BIG-TTS/Hypnos/Hypnos/Programming/Accelerometer Configuration.odt

Accelerometer Configuration:

Control configuration:

- Standby mode with sample rate of 100Hz and low noise activated -> 0x1C into 0x2A register
- Select Low Noise Low Power as oversampling mode -> 0x01 into 0x2B register

Transient Control Configuration (Enable which axis is monitored):

- Write to Register 0x1D
- Write 0x0E -> This enables an Interrupt on all three axis
- Write 0x4E if event flags should be latched into SRC register

Transient Threshold Configuration (value to exceed for an event to happen):

- Write Register 0x1F
- Select 0.5g as Threshold -> 0.5g/0.063g -> 8 counts -> Write 0x08

Transient Counter Configuration (time for an event to persist, so it is recognized):

- Write Register 0x20
- Set timing of detection to 50ms -> 10ms Steps -> 50/10 -> Write 0x05

Transient Source Configuration (data on which axis and direction event occurred):

- Write Register 0x1E
- To clear event flag -> Read 0x40
- Bit 0-5 contain information about axis and direction (POLX, EVX, POLY, EVY, POLZ, EVZ)

System Interrupt Configuration:

- Enable the Interrupt for Transient detection -> Write Register 0x2D -> Write 0x20
- Route Transient Detection to Interrupt Pin 1 -> Write Register 0x2E -> Write 0x20
- To clear interrupt flag -> Write Register 0x0C -> Read 0x20

Put device into active mode:

- Write 0x1D into 0x2A register
