BIG-TTS/Hypnos/Hypnos/Programming/Clock Configuration.odt

STM32L431CC Clock Configuration

The clock configuration of Hypnos_V0 is described in individual sections for the main clocks. The system clock is driven by the PLL, which used the MSI as clock source. The MSI is configured to 4MHZ and auto calibrated by the LSE. The LSE provides the clock source for the RTC.

After leaving one of the low-power modes, the configuration of the MSI range is lost and set to the default value of 4MHz. So keeping this value for the whole configuration has the advantage that the MSI doesn’t need to be reconfigured after a reset.

The following steps have to be taken for the whole clock configuration of the system to work:

- Configure the RTC clock
- Configure the LSE
- Configure the MSI
- Enable power interface clock -> SET PWREN bit in RCC_APB1ENR1 register
- Set voltage regulator range -> Configure VOS bits in PWR_CR1 register
- Enable backup domain access -> SET DBP bit IN PWR_CR1 register
- Disable flash prefetch buffer -> Clear PRFTEN bit in FLASH_ACR register
- Enable flash instruction cache -> Set ICEN bit in FLASH_ACR register
- Enable flash data cache -> Set DCEN bit in FLASH_ACR register
- Configure Flash Latency -> Set Latency bits in FLASH_ACR register
- Configure the PLL
- Configure the System Clock

PLL (Phase-locked loop) clock:

The PLL is used to multiply the HSE, HSI or MSI output clock frequency and generate with these internal clock sources a much higher clock speed for the system.

- Disable the PLL -> Clear PLLON bit in RCC_CR register
- Wait until PLL is turned off -> Wait until PLLRDY bit is cleared in RCC_CR register
- Define the clock source for the PLL -> Configure PLLSRC bits in RCC_PLLCFGR register
- Set division factor for the input clock -> Configure PLLM bits in RCC_PLLCFGR register
- Set the multiplication factor -> Configure PLLN bits in RCC_PLLCFGR register
- Set division factor for output clock -> Configure PLLR bits in RCC_PLLCFGR register
- Enable PLL again -> Set PLLON bit in RCC_CR register
- Wait for PLL to be stable -> Wait until PLLRDY flag is set in RCC_CR register
- Enable PLL output -> Set PLLREN bit in RCC_PLLCFGR register

LSE (Low Speed External) Clock:

The LSE is an external crystal. It provides the clock source for the RTC and keeps the System clock accurate by trimming the MSI.

- Set crystal oscillator driving strength > Program LSEDRV bits in RCC_BDCR register
- Turn LSE crystal on -> SET LSEON bit in RCC_BDCR register
- Wait for LSE to be stable -> Wait until LSERDY flag is set in RCC_BDCR register
- Activate clock security system (only after clock source has been selected for the RTC) -> SET LSECSSON bit in RCC_BDCR register

MSI (Multi Speed Internal) clock:

The MSI is used as system clock after restart from reset, wakeup, standby and shutdown low- power modes. It is set to the default value of 4MHz.

- Change range with MSIRANGE[3:0] bits in RCC_CR register (keep at reset value)
- Turn on the MSI -> SET MSION in RCC_CR register
- Wait for MSI to be stable -> Wait until MSIRDY flag is set in RCC_CR register
- Enable auto calibration by LSE (PLL-mode) -> Set MSIPLLEN bit in RCC_CR register

SYSCLK (System clock):

The SYSCLK is the one, which drives the whole system. Different sources can be used. In this case, to allow auto calibration of the MSI, the PLL is used as source for the system clock.

- Configure AHB prescaler -> Configure HPRE bits in RCC_CFGR register
- Configure APB1 prescaler -> Configure PPRE1 bits in RCC_CFGR register
- Configure APB2 prescaler -> Configure PPRE2 bits in RCC_CFGR register
- Select the system clock source -> Configure SW bits in RCC_CFGR register
- Confirm status of clock source -> Wait until corresponding SWS bits are set in RCC_CFGR register

RTC Clock:

- Select LSE as clock source -> RTCSCEL = 01 in RCC_BDCR register
- Configure prescaler with 1Hz RTC clock -> PREDIV_A = 127 & PREDIV_S = 255
- Enable RTC clock -> Set RTCEN bit in RCC_BDCR register

Any changes in the backup domain register require a software reset by setting the BDRST bit in RCC_BDCR register

https://www.youtube.com/watch?v=GJ_LFAlOlSk
