BIG-TTS/Hypnos/Hypnos/Programming/I2C Configuration.odt

STM32L431CB I2C Configuration

I2C initialization:

- Make sure peripheral clock is configured and enabled -> Check configuration in RCC registers
- Disable the I2C clock -> Clear PE bit in I2C_CR1 register (also performs software reset)
- Configure Noise Filters -> ANFOFF, DNF in I2C_CR1 (Leave default configuration)
- Configure timings (Cube) -> PRESC, SCLDEL, SDADEL, SCLH, SCLL in I2C_TIMINGR register
- Enable the I2C clock -> Set PE bit in I2C_CR1 register

Data Transfer:

Reception:

- Data goes in shift register -> RXNE = 0
- Data goes in data register (I2C_RXDR) -> RXNE = 1
- Next Data goes in shift register -> Clock is stretched since shift and data registers are full
- After reading data in I2C_RXDR-> Clock is released, but RXNE stays set

Transmission:

- Data gets written into data register I2C_TXDR -> TXE is cleared
- Data goes to shift register -> Data register empty -> TXE = 1
- If no new data -> Clock is stretched since shift and data registers are empty
- After writing data in I2C_TXDR -> Clock is released, TXE stays set

Byte counter:

- The number of transferred and received bytes is counted
- In Master mode always enabled
- In slave mode can be enabled by setting SBC bit in I2C_CR2
- The number of bytes for transfer must be programmed -> NBYTES in I2C_CR2

Reload = 1

- If number of bytes to transfer is greater than 255 -> Set RELOAD bit in I2C_CR2
- If number of bytes have been written -> TCR flag is set and clock is stretched
- Interrupt is generated if TCIE set
- TCR is cleared by writing new non-zero value into NBYTES
- IF NBYTES reloaded with last number of bytes -> RELOAD bit must be cleared

Reload = 0 and AUTOEND = 1

- Stop condition automatically sent after NBYTES is reached in transfer

Reload = 0 and AUTOEND = 0

- Clock is stretched after NBYTES is reached in transfer
- TCR flag is set and clock is stretched
- Interrupt is generated if TCIE set
- TCR is cleared by sending RESTART or STOP condition

I2C master mode:

- Configure addressing mode (7-bit or 10-bit) -> ADD10 in I2C_CR2
- Write slave address to be sent -> Write into SADD in I2C_CR2
- Set Transfer direction -> RD_WRN in I2C_CR2
- Configure Byte counter -> NBYTES in I2C_CR2 (If greater than 255 -> Initially 0xFF)
- Send START bit in I2C_CR2

Master transmitter:

- TXIS flag set after each byte transmission
- TXIS event generated if TXIE bit set in I2C_CR1 register
- Transfer stops once the number of TXIS events corresponds to the number in NBYTES
- For Restart -> Set Start bit with proper slave address and NBYTES configuration
- For Stop -> Set Stop bit in I2C_CR2 register
- If NACK received -> TXIS cleared, STOP sent, NACKF set (Interrupt if NACKIE = 1 in I2C_ISR)

Master receiver:

- RXNE flag set after each byte reception
- RXNE event generated if RXIE bit set in I2C_CR1
- Reception stops once the number of RXNE events corresponds to the number in NBYTES
- For Restart -> Set Start bit with proper slave address and NBYTES configuration
- For Stop -> Set Stop bit in I2C_CR2 register

Before entering Stop mode, the I2C must be disabled if WUPEN = 0.
