BIG-TTS/Hypnos/Hypnos/Programming/Power Control Configuration.odt

Power control configuration

Voltage regulator:

Two embedded linear voltage regulators supply all the digital circuitries, expect for standby and backup circuitries. They’re always enabled after reset. Depending on the application modes, Vcore is either supply by the main regulator (MR) or the low-power regulator (LPR).

- In Run, Sleep and Stop 0 -> MR & LPR are on, Vcore is supplied by MR
- In LP run & sleep and Stop 1 & 2 -> Only LPR is on and supplies Vcore, SRAM 1 & 2 are preserved
- In Standby mode (RRS bit set) -> Only LPR is on and supplies SRAM2, everything is off except Standby and backup domain circuitry
- In Standby mode (RRS bit cleared) -> LPR & MR are off, only standby and backup domain circuitry are preserved
- In Shutdown mode -> LPR & MR are off, after exiting power-on reset is generated

Setting the RSS bit in PWR_CR3 register allows to retain the content of SRAM2 in standby mode

Voltage scaling management_

The main regulator output voltage (Vcore) can be programmed to two different power ranges (Range 1 and Range 2). After start-up, the voltage scaling is set to range 1.

- Range 1 is the high-performance range. The system clock can get up to the maximum. Flash access time is minimum.
- Range 2 is the low-power range. The system clock can only be up to 26MHz. Flash access time is increased.

To go from range 1 to range 2:

- Reduce the system frequency to 26Mhz or lower
- Adjust the Flash latency -> LATENCY bits in FLASH_ACR
- Select voltage scaling range 2 -> Set VOS bits to 10 in PWR_CR1 register

To go from range 2 back to range 1:

- Select voltage scaling range 1 -> Set VOS bits to 01 in PWR_CR1 register
- Wait until scaling has switched-> Wait until VOSF flag is cleared in PWR_SR2 register
- Adjust the Flash latency -> LATENCY bits in FLASH_ACR
- Increase the system frequency

Battery backup domain:

When VDD is not present, the backup domain is powered through the backup supply voltage VBAT. The switch is controlled by the power-down reset. The battery/capacitor connected to VBAT can be internally charged by the microcontroller:

- Enable battery charging -> SET VBE bit in PWR_CR4 register
- Chose battery charging resistor -> Configure VBRS bit in PWR_CR4

After a System reset, the backup registers are protected. To enable access to the backup domain:

- Enable power interface clock -> Set PWREN bit in RCC_APB+ENR+ register
- Enable access to the backup domain -> Set DBP bit in PWR_CR1 register
- Proceed with the RTC clock configuration

Run mode:

- In run mode, the clock and peripherals of the whole system are completely functional. The different clocks of the system can be configured individually to either reduce power consumption or switch into another mode.
- The HCLK and PCLK can be stopped at any time.
- Stop clock for individual peripherals with the RCC_AHBxENR and RCC_APBxENR registers.
- In sleep mode, disabling the peripherals clock can be performed automatically by resetting the corresponding bit in the RCC_AHBxSMENR and RCC_APBxSMENR registers

Low-power run mode (LP run)

- Maximum frequency cannot exceed 2MHz
- All I/o modes keep the same state as in run mode
- All clocks working, except PLL

To enter LP run mode:

- Decrease system clock to 2MHz or lower
- Force regulator into low-power mode –> Set LPR bit in PWR_CR1 register

To exit LP run mode:

- Force regulator into run mode -> Clear LPR bit in PWR_CR1 register
- Wait until System is ready -> Wait until REGLPF bit is cleared in PWR_SR2 register
- Increase system clock frequency

Sleep mode:

- All I/o modes keep the same state as in run mode
- Current Consumption drastically reduced
- All Clocks working
- CPU off

To enter sleep mode:

- Clear SLEEPDEEP bit in SCR register
- Make sure no Interrupt or Event is pending
- Enable Wakeup pin if used
- Set WFI or WFE instruction

Depending on configuration, sleep mode is exited in different ways:

- If WFI instruction set -> System wakes up if an interrupt occurs
- If WFE instruction set -> System wakes up if an event occurs
- If WFE instruction set (SEVONPEND bit in SCR register set) -> System wakes up if an interrupt occurs, even when not enabled in NVIC
- If SLEEPONEXIT in SCR register set -> System exits if an interrupt occurred and goes back to sleep mode after returning from the handler

Low-power sleep mode (LP sleep):

- All I/o modes keep the same state as in run mode
- Current Consumption drastically reduced
- All Clocks working, except PLL
- CPU off
- Can only be accessed from LP Run mode

To enter LP sleep mode:

- Clear SLEEPDEEP bit in SCR register
- Make sure no Interrupt or Event is pending
- Enable Wakeup pin if used
- Set WFI or WFE instruction

Depending on configuration, LP sleep mode is exited in different ways:

- If WFI instruction set -> System wakes up if an interrupt occurs
- If WFE instruction set -> System wakes up if an event occurs
- If WFE instruction set (SEVONPEND bit in SCR register set) -> System wakes up if an interrupt occurs, even when not enabled in NVIC
- If SLEEPONEXIT in SCR register set -> System exits if an interrupt occurred and goes back to sleep mode after returning from the handler

Stop 0 mode:

- All I/o modes keep the same state as in run mode
- Current Consumption is reduced t 108uA
- Only LSE and LSI clock working
- Several peripherals are still functioning
- CPU off

To enter Stop 0 mode:

- Set the SLEEPDEEP bit in SCR register
- Select STOP 0 as LP mode -> SET LPMS to 000 in PWR_CR1 register
- Make sure no Interrupt or Event is pending
- Enable Wakeup pin if used
- Set WFI or WFE instruction

Depending on configuration, stop 0 mode is exited in different ways:

- If WFI instruction set -> System wakes up if an interrupt (external or peripheral with wakeup capability) occurs
- If WFE instruction set -> System wakes up after if an external event occurs
- If WFE instruction set (SEVONPEND bit in SCR register set) -> System wakes up if an interrupt (external or peripheral with wakeup capability) occurred, even when not enabled in NVIC
- If SLEEPONEXIT in SCR register set -> System exits if an interrupt occurred and goes back to sleep mode after returning from the handler

After exiting Stop 0 mode, either the MSI or the HSI16 is selected as System clock. It depends on the STOPWUCH bit in the RCC_CFGR register. Set for HSO16, cleared for MSI. The MSI allows faster wakeup time and higher clock frequency after reset. He MCU is after exiting either in run mode range 1 or 2.

Stop 1 mode:

- All I/o modes keep the same state as in run mode
- LPR is used which allows less current consumption (4.63uA with RTC)
- Only LSE and LSI clock working
- Several peripherals are still functioning
- CPU off
- Can be entered from Run or LP Run mode

Entering and exiting is the same as stop 0 mode with the only difference of LPMS set to 001

Stop 2 mode:

- All I/o modes keep the same state as in run mode
- LPR is used which allows less current consumption (1.4uA with RTC)
- Only LSE and LSI clock working
- Only few peripherals still functioning
- CPU off
- Can only be entered from Run mode

Entering and exiting is the same as stop 0 mode with the only difference of LPMS set to 010

Standby mode:

- SRAM1 contents are lost
- SRAM2 content preserved depending on the RSS bit in PWR_CR3 register
- CPU off
- Only BOR, RTC and IWDG functioning
- I/O configuration can be floating, pull-up or pull-down
- Only LSE clock on

To enter standby mode:

- Set the SLEEPDEEP bit in SCR register
- Select standby as LP mode -> SET LPMS to 011 in PWR_CR1 register
- Clear WUFx bits in PWR_SR1 register
- Make sure no Interrupt or Event is pending
- Enable Wakeup pin if used
- Set WFI or WFE instruction
- If SLEEPONEXIT in SCR register set -> System goes back to sleep mode after returning from the ISR handler (only if RTC flags cleared)

Depending on configuration, standby mode is exited in different ways:

- Rising edge on Wakeup pin
- RTC event
- External reset
- IWDG reset

After exiting standby mode, the SBF status flag in PWR_CR3 is set to indicate it was in standby mode. All registers are reset after a wakeup, except PWR_CR3. GPIOS keep their configuration from standby mode until the APC bit in PWR_CR3 has been cleared. The pin configuration of the I/O in standby mode is lost after waking up

Shutdown mode:

- SRAM1 and SRAM2 contents are lost
- CPU off
- Only RTC functioning
- I/O configuration can be floating, pull-up or pull-down
- Only LSE clock on
- 200nA power consumption with RTC

To enter shutdown mode:

- Set the SLEEPDEEP bit in SCR register
- Select shutdown as LP mode -> SET LPMS to 1xx in PWR_CR1 register
- Clear WUFx bits in PWR_SR1 register
- Make sure no Interrupt or Event is pending
- Enable Wakeup pin if used
- Set WFI or WFE instruction
- If SLEEPONEXIT in SCR register set -> System goes back to sleep mode after returning from the ISR handler (only through external RTC event possible and if flags cleared afterwards)

Depending on configuration, shutdown mode is exited in different ways:

- Rising edge on Wakeup pin
- RTC event
- External reset

The whole system is completely reset. All registers are reset, except for the backup domain

Auto-wakeup from low-power mode through RTC

- To wake up from stop mode through a RTC alarm -> configure EXTI line 18 to be sensitive to rising edge
- To wake up from a stop mode through a RTC wakeup event -> configure EXTI line 20 to be sensitive to rising edge
- To wake up from standby there is no special configuration necessary

https://www.youtube.com/watch?v=O82rj9qxkgs

Important: 3.3.3 Read access latency
