BIG-TTS/Hypnos/Hypnos/Programming/RTC Configuration.odt

Configuration of the RTC

Calendar Configuration:

- Disable write protection -> Write 0xCA and then 0x53 in RTC_WPR register
- Enter Init mode -> Set Init Bit in RTC_ISR register
- Wait for confirmation of Init mode -> wait until INITF bit is set in RTC_ISR register
- Program prescaler value in RTC_PRER register -> per default 1Hz
- Write time and date in register -> RTC_DR (Date) & RTC_TR (Time)
- Configure time format -> Clear FMT bit in RTC_CR (24hour format)
- Exit Init mode -> Clear Init bit in RTC_ISR register
- Enable write protection -> Write 0xFF into RTC_WPR register

Clock Configuration:

- Select LSE as clock source -> RTCSCEL = 01 in RCC_BDCR register
- Configure prescaler with 1Hz RTC clock -> PREDIV_A = 127 & PREDIV_S = 255
- Enable RTC clock -> Set RTCEN bit in RCC_BDCR register

Any changes in the backup domain register require a software reset by setting the BDRST bit in RCC_BDCR register

Alarm Configuration:

- Disable write protection -> Write 0xCA and then 0x53 in RTC_WPR register
- Disable Alarm A(B) -> Clear ALRA(B)E bit in RTC_CR register
- Wait until alarm register can be accessed -> wait until ALRA(B)WF is set in RTC_ISR register
- Configure alarm -> Write into RTC_ALRMA(B)R register (must be same format as calendar)

WDSEL defines whether the date or only the weekday is represented in the alarm.

- Re-enable alarm -> SET ALRA(B)E bit in RTC_CR register
- The alarm interrupt is enabled through the ALRA(B)IE bit in the RTC_CR register

Alarm behaviour configuration:

The alarm behaviour is configured by the MSKx bits in the RTC_ALRMA(B)R register. They can be set independently from each other.

- IF MSK0 = 1 -> Seconds don’t matter in comparison
- IF MSK1 = 1 -> Minutes don’t matter in comparison
- IF MSK2 = 1 -> Hours don’t matter in comparison
- IF MSK3 = 1 -> Weekday or date don’t matter in comparison

Alarm sub-second configuration:

The RTC unit provides programmable alarms, sub-second A and B, which are similar. They generate alarms with a high resolution (for the second division).

The value programmed in the alarm sub-second register RTC_ALRMASSR is compared to the content of the sub-second field in the calendar unit.

The sub-second field counter counts down from the value configured in the synchronous prescaler (PREDIV_S) to zero, and then reloads a value from the RTC_SPRE register.

- Write the sub seconds value to be compared -> Set SS bits in RTC_ALRMASSR register
- Mask the most significant bit to be compared -> Set MASKSS bits in RTC_ALRMASSR regiser

Periodic wakeup unit:

This unit is able to wake up the system from low-power modes. It uses a programmable down-counting auto-reload timer. Once the counter reaches zero, a flag and interrupt is generated. An alternate function output is also available which can be routed to RTC_ALARM output.

- Disable write protection -> Write 0xCA and then 0x53 in RTC_WPR register
- Disable wakeup timer -> Clear WUTE bit in RTC_CR register
- Wait until wakeup registers can be accessed -> Wait until WUTWF bit set in RTC_ISR register
- Program wakeup timer value _> SET WUT bits in RTC_WUTR register
- Select LSE as clock source for short wakeup periods -> WUCKSEL bits = 0b0xx in RTC_CR register
- Configure prescaler to select resolution

If Wucksel = 000 -> Division = 16

If Wucksel = 001 -> Division = 8

If Wucksel = 010 -> Division = 4

If Wucksel = 011 -> Division = 2

- Re-enable wakeup timer -> SET WUTE bit in RTC_CR register
- Enable write protection -> Write 0xFF in RTC_WPR register
- The periodic wakeup interrupt is enabled through the WUTIE bit in the RTC_CR register

Backup System:

- Data can be saved in this register. They keep being powered on, even if VDD is switched off.
- 32 Bits are available
- It is not reset by a system reset

After a System reset, the backup registers are protected. To enable access to the backup domain:

- Enable power interface clock -> Set PWREN bit in RCC_APB+ENR+ register
- Enable access to the backup domain -> Set DBP bit in PWR_CR1 register
- Proceed with the RTC clock configuration

Reading the calendar:

APB1 clock (fplclk) must be at least 7 times greater than the RTC clock to ensure proper reading of the calendar registers. The values from the calendar are copied into shadow registers in an interval of 1/RTCCLK. The registers can be read directly by setting the BPYSHAD Bit in RTC_CR register. Per default it is cleared to ensure accuracy in reading.

- RSF bit in RTC_ICSR register is set every time calendar value is copied into shadow register
- Read RTC_SSR or RTC_TR before reading RTC_DR -> Locks shadow register until RTC_DR is read
- If calendar is read in smaller periods than 1/RTCCLK -> RSF bit must be cleared by software
- After waking up from stop or standby -> RSF bit must be cleared by software

It must be ensured, that the SRF bit is set before reading the corresponding registers.

Smooth Calibration:

The RTC frequency can be digitally calibrated with a range from -487.1 ppm to +488.5 ppm. The correction is performed using series of small adjustments. This Adjustments are made by either adding or masking pulses to the frequency in a calibration window of a certain time. The calibration window can be reduced from 32s to 16 or 8s but reduced the accuracy.

- Set LPCAL bit in RTC_CALR register if low-power mode is used
- Increase frequency by setting CALP bits in RTC_CALR register
- Reduce frequency by setting CALM bits in RTC_CALR register
- Reduce calibration window by setting CALW8 or CLAW16 bit in RTC_CALR register

Calibration clock output:

For 512Hz Output:

- Set asynchronous prescaler to default value -> PREDIV_A = 127
- Enable output calibration -> Set COE bit in RTC_CR register
- Select 512Hz as output -> Clear COSEL bit in RTC_CR register

For 1Hz Output:

- Set asynchronous prescaler to default value -> PREDIV_A = 127
- Set synchronous prescaler to default value -> PREDIV_S = 255
- Enable output calibration -> Set COE bit in RTC_CR register
- Select 1Hz as output -> Set COSEL bit in RTC_CR register

Reducing power consumption:

- Set Oscillator driving strength to the lowest level
- Configure Value of the asynchronous prescaler as high as possible
- Use tamper pin internal pull-up resistor
