BIG-TTS/Hypnos/Hypnos/Drawings/Communication.pdf

# Communication

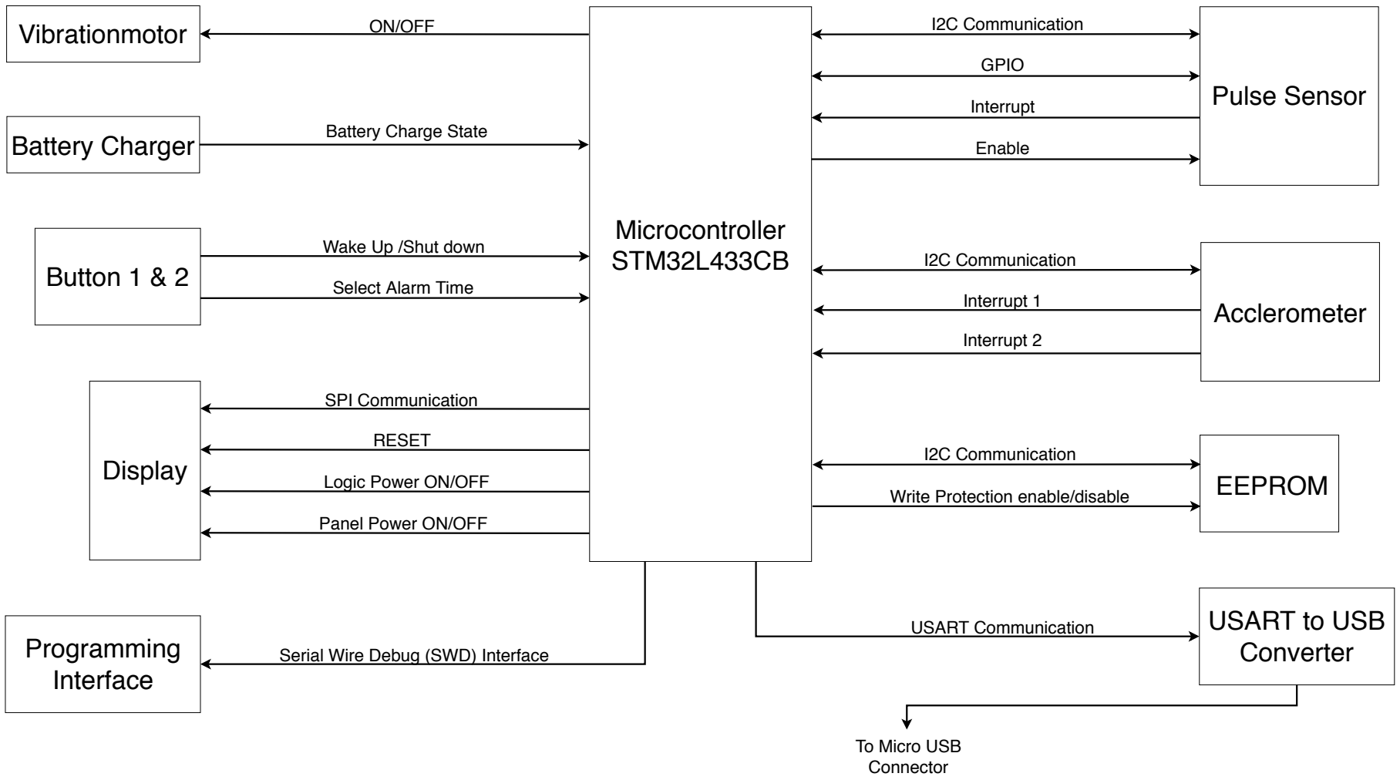
[picture p37: figure]
Microcontroller STM32L433CB; Pulse Sensor; Button 1 & 2; EEPROM; I2C Communication; Interrupt; GPIO; Enable; Write Protection enable/disable; Acclerometer; Interrupt 2; Interrupt 1; Vibrationmotor; ON/OFF; Battery Charger; Battery Charge State; Wake Up /Shut down; Select Alarm Time; Display; SPI Communication; RESET; Logic Power ON/OFF; Panel Power ON/OFF; USART to USB; Programming; Converter; Interface; USART Communication; Serial Wire Debug (SWD) Interface; To Micro USB Connector
