BIG-TTS/Hypnos/Hypnos/Drawings/Clock.pdf

# Clock

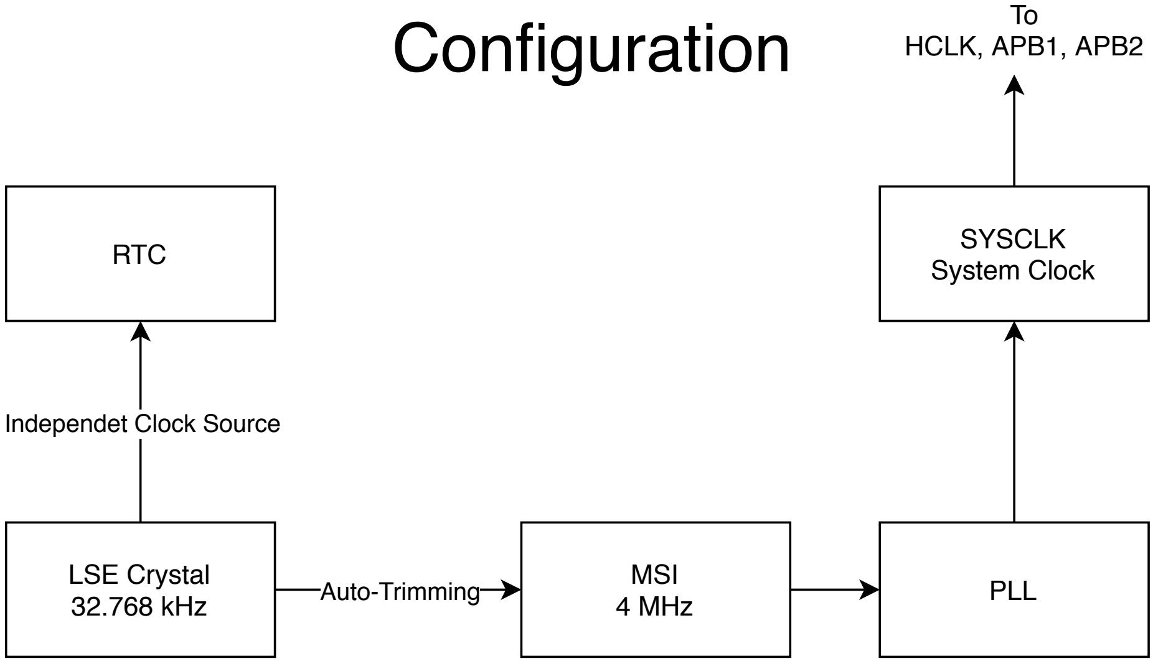
[picture p38: figure]
RTC; LSE Crystal 32.768 kHz; MSI; 4 MHz; PLL; SYSCLK System Clock; Auto-Trimming; Independet Clock Source; Configuration; HCLK, APB1, APB2
