BIG-TTS/Hypnos/Hypnos/Production/Stückliste.ods

Component | Description | Name | Quantity Total | P/N
J1 | Micro USB Connector | MOLEX 47346-0001 | 5
U1 | Battery Charger | MCP73831T | 5
U2 | Power Distribution Switch | SIP32431DR3 | 5
U3 | Power supervisor | TPS3619 | 5 | 80300
U4 | Display Power Converter | MIC2290YML | 5
U5 | Curcuit Power converter | TPS62202 | 5
U6 | USART to USB converter | FT234XD | 5
U7 | ESD Surpresser | USBLC6-2 | 5 | 168008
U8 | Microcontroller | STM32L431CB | 5
U9 | Pulse Sensor | MAXM86161 | 5
U10 | Accelerometer | MMA8451Q | 5 | 162150
U11 | EEPROM | BR24T1MFJ-3AME2 | 5
R1, R5, R8, R9, R11, R12 | Resistor | 10k | 30 | 55506
R4, R13, R14 | Resistor | 4.7k | 15 | 53984
R3 | Resistor | 43k | 5 | 56749
R6, R7 | Resistor | 27R | 10
R10 | Resistor | 0R | 5 | 50686
R15 | Resistor | 910k | 5 | 163041
R16 | Resistor | 100k | 5 | 57449
C1, C4, C6, C7, C14, C15, C24, C25, C26, C28, C32, C33, C38 | Capacitor | 100nF | 65 | 3644
C2,C3,C8, C11, C23, C29 | Capacitor | 10uF | 30 | 1367
C5, C20, C30, C31, C34, C35, C36, C37 | Capacitor | 1uF | 40 | 154773
C9 | Capacitor | 2,2uF | 5 | 2340
C10, C27 | Capacitor | 4,7uF | 10
C12, C13 | Capacitor | 47pF | 10 | 4665
C16, C21, C22 | Capacitor | 10nF | 15 | 2883
C17,C18 | Capacitor | 10pF | 10 | 4344
C19 | Super Capacitor | DSK-3R3H224U-HL | 5
L1, L2 | Inductor | 10uH | 10 | 34143
Q1 | FET | BSS138L | 5 | 154612
D1 | Diode | MSS1P2L-M3 | 5
S1, S2 | Tactical Switch | EVQ-P7J01P | 10
Y1 | Quarz, 32.768kHz | ECS-.327-12.5-34B-C-TR | 5 | 182509
FB1 | FERRITE | 742792620, Wurth | 5 | 172890
