BIG-TTS/Hypnos/Hypnos/Drawings/Power Management.pdf

## Step-Down Converter

## Battery

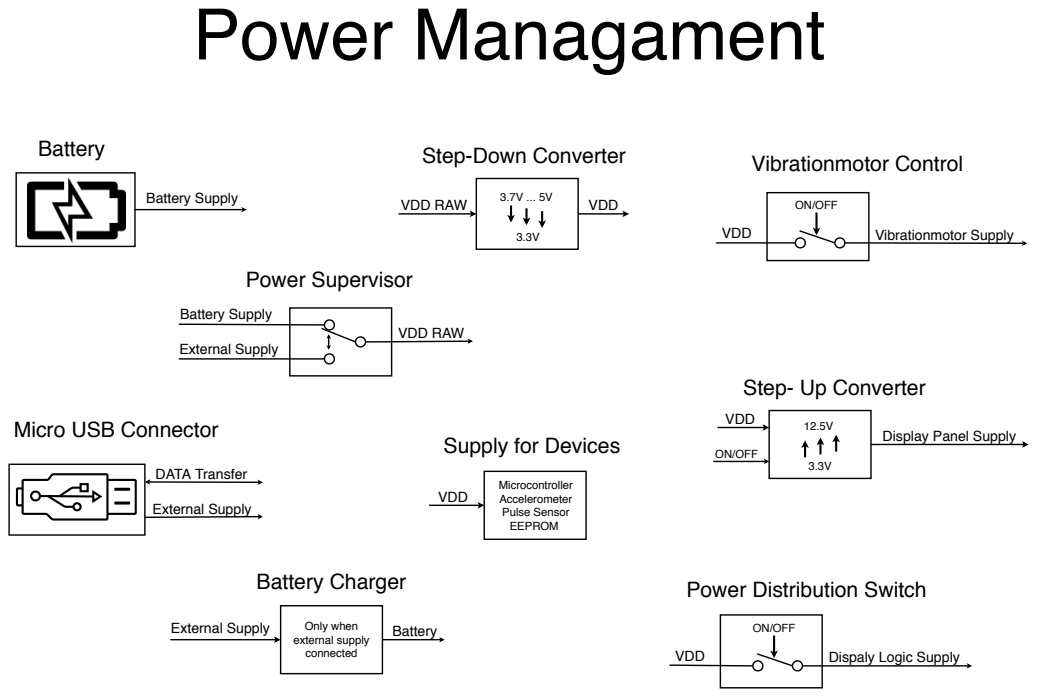
[picture p39: page 1]
Power Supervisor; External Supply; Battery Supply; VDD RAW; VDD; Battery Charger; DATA Transfer; Only when external supply connected; Battery; Microcontroller Accelerometer Pulse Sensor EEPROM; Vibrationmotor Control; Vibrationmotor Supply; ON/OFF; Power Managament

Step- Up Converter

Micro USB Connector

Display Panel Supply

Supply for Devices

Power Distribution Switch

Dispaly Logic Supply
