BIG-TTS/Hypnos/Hypnos/Production/Hypnos_V0.1/Hypnos_V0_SCH.pdf

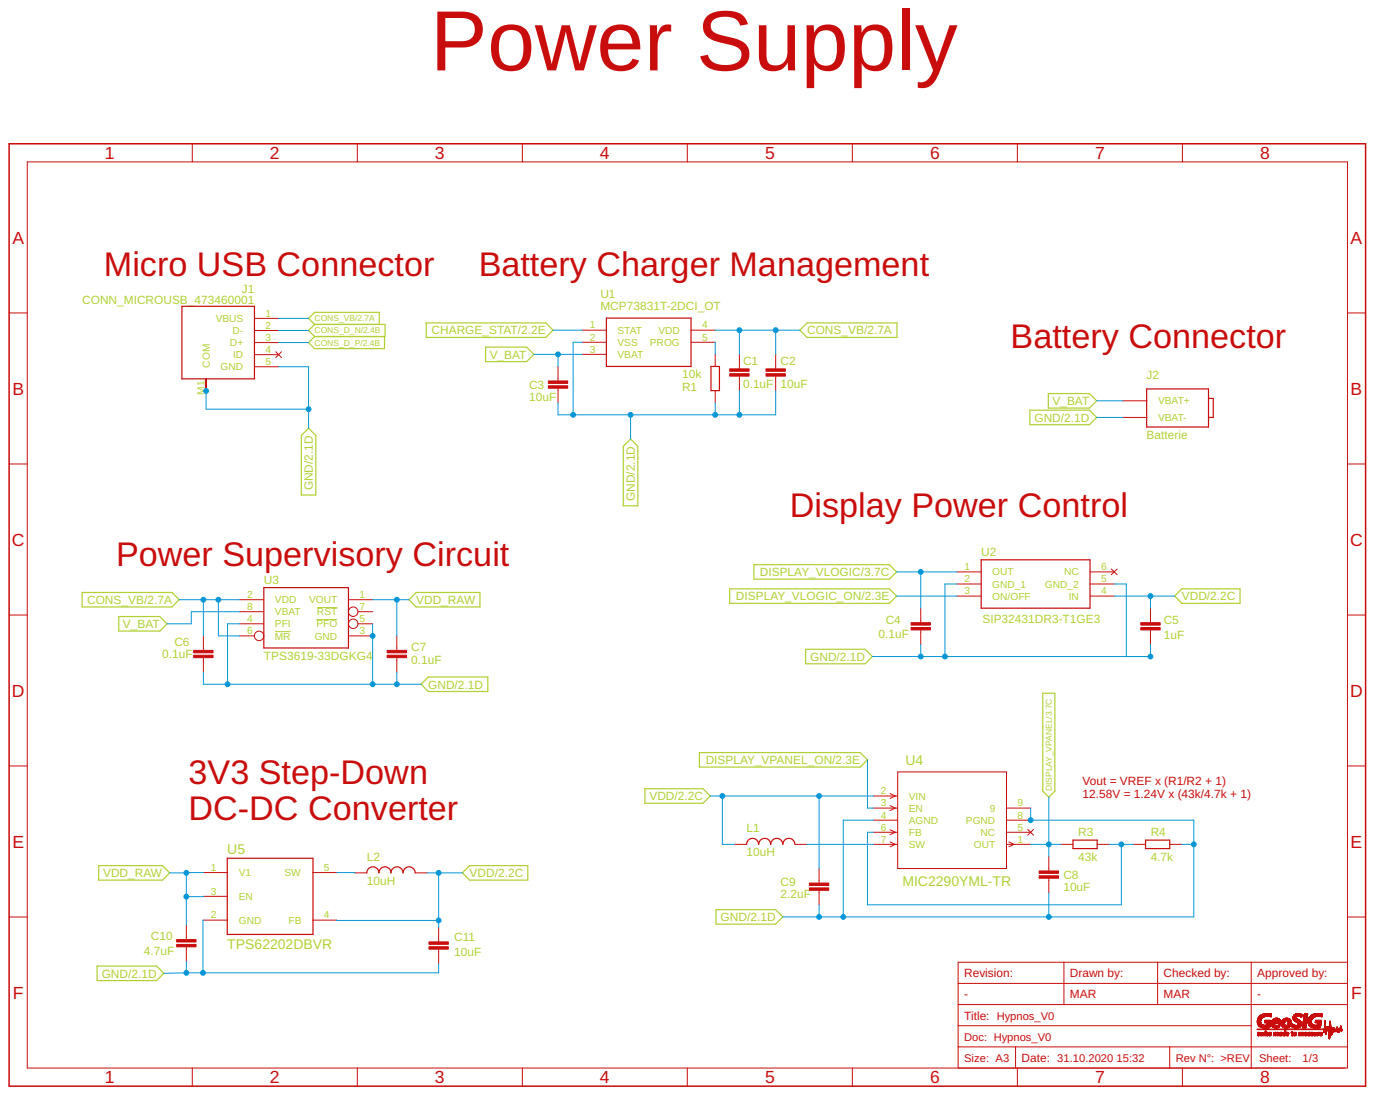
[picture p40: page 1]

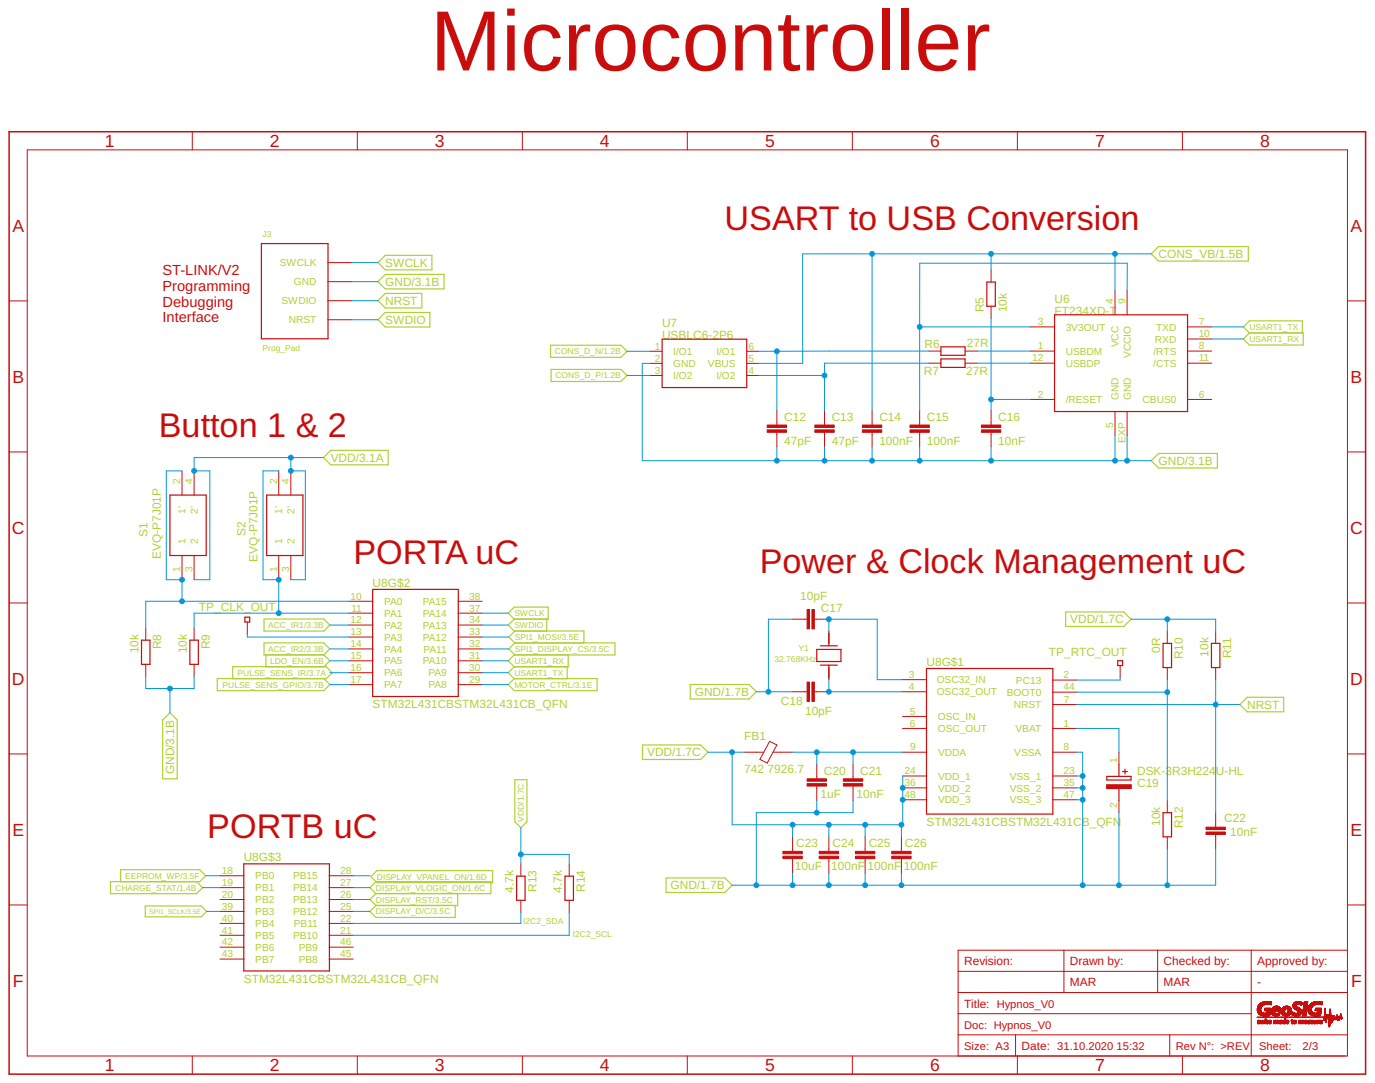
[picture p41: page 2]

USART to USB Conversion

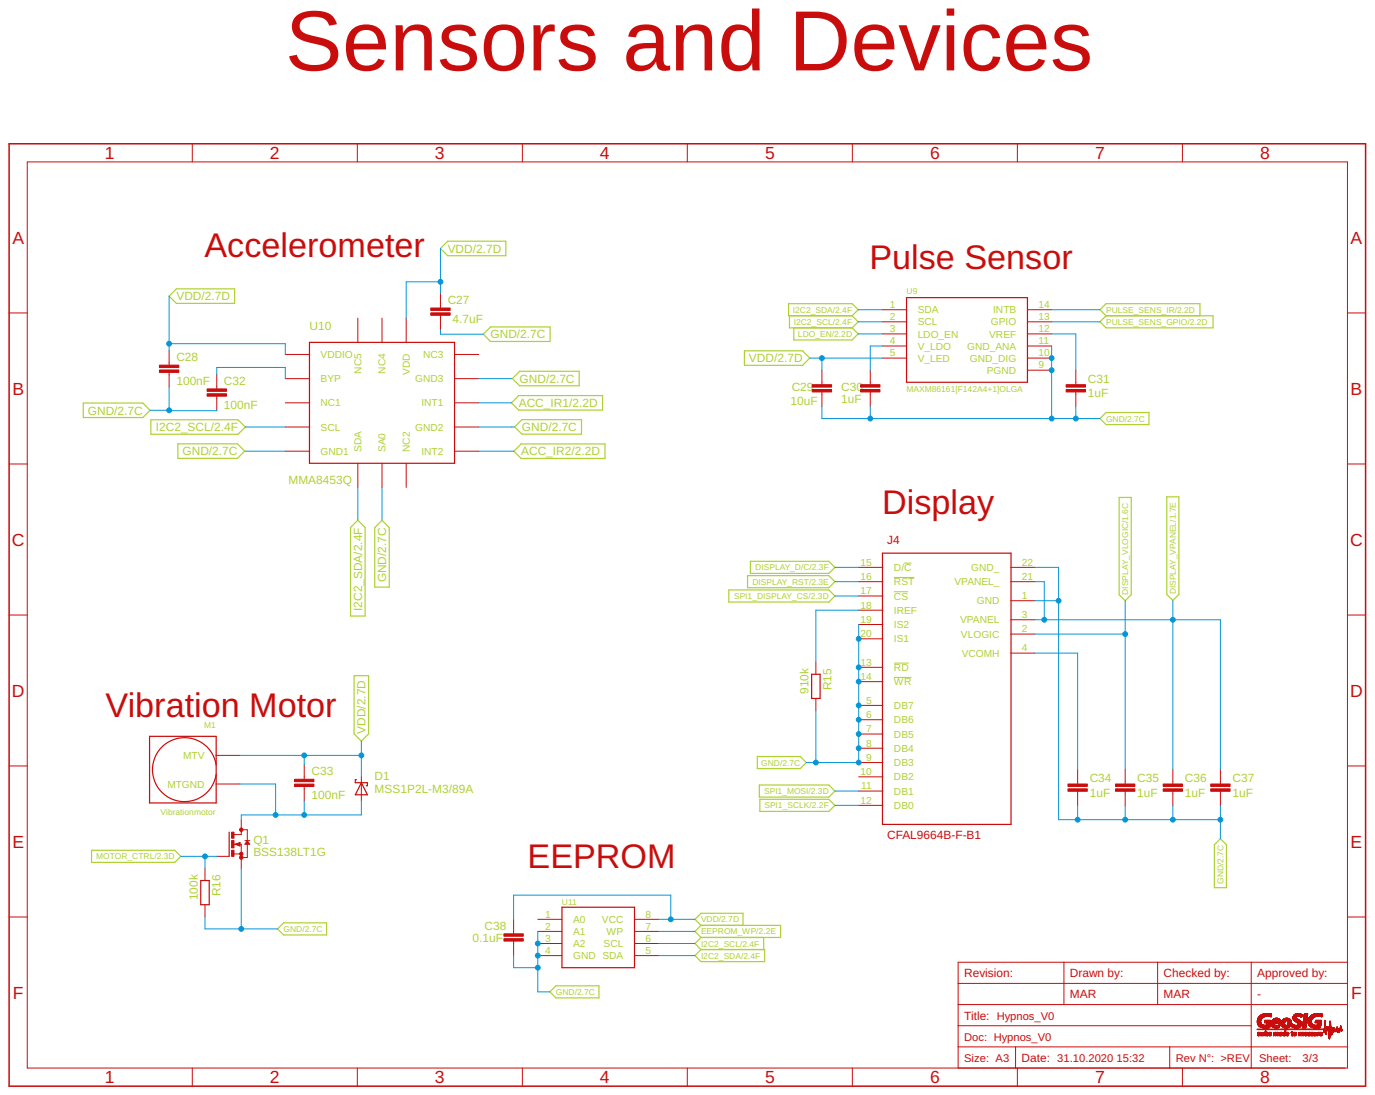
[picture p42: page 3]
