BIG-TTS/Hypnos/Hypnos/Production/Hypnos_V0/Hypnos_V0_SCH.pdf

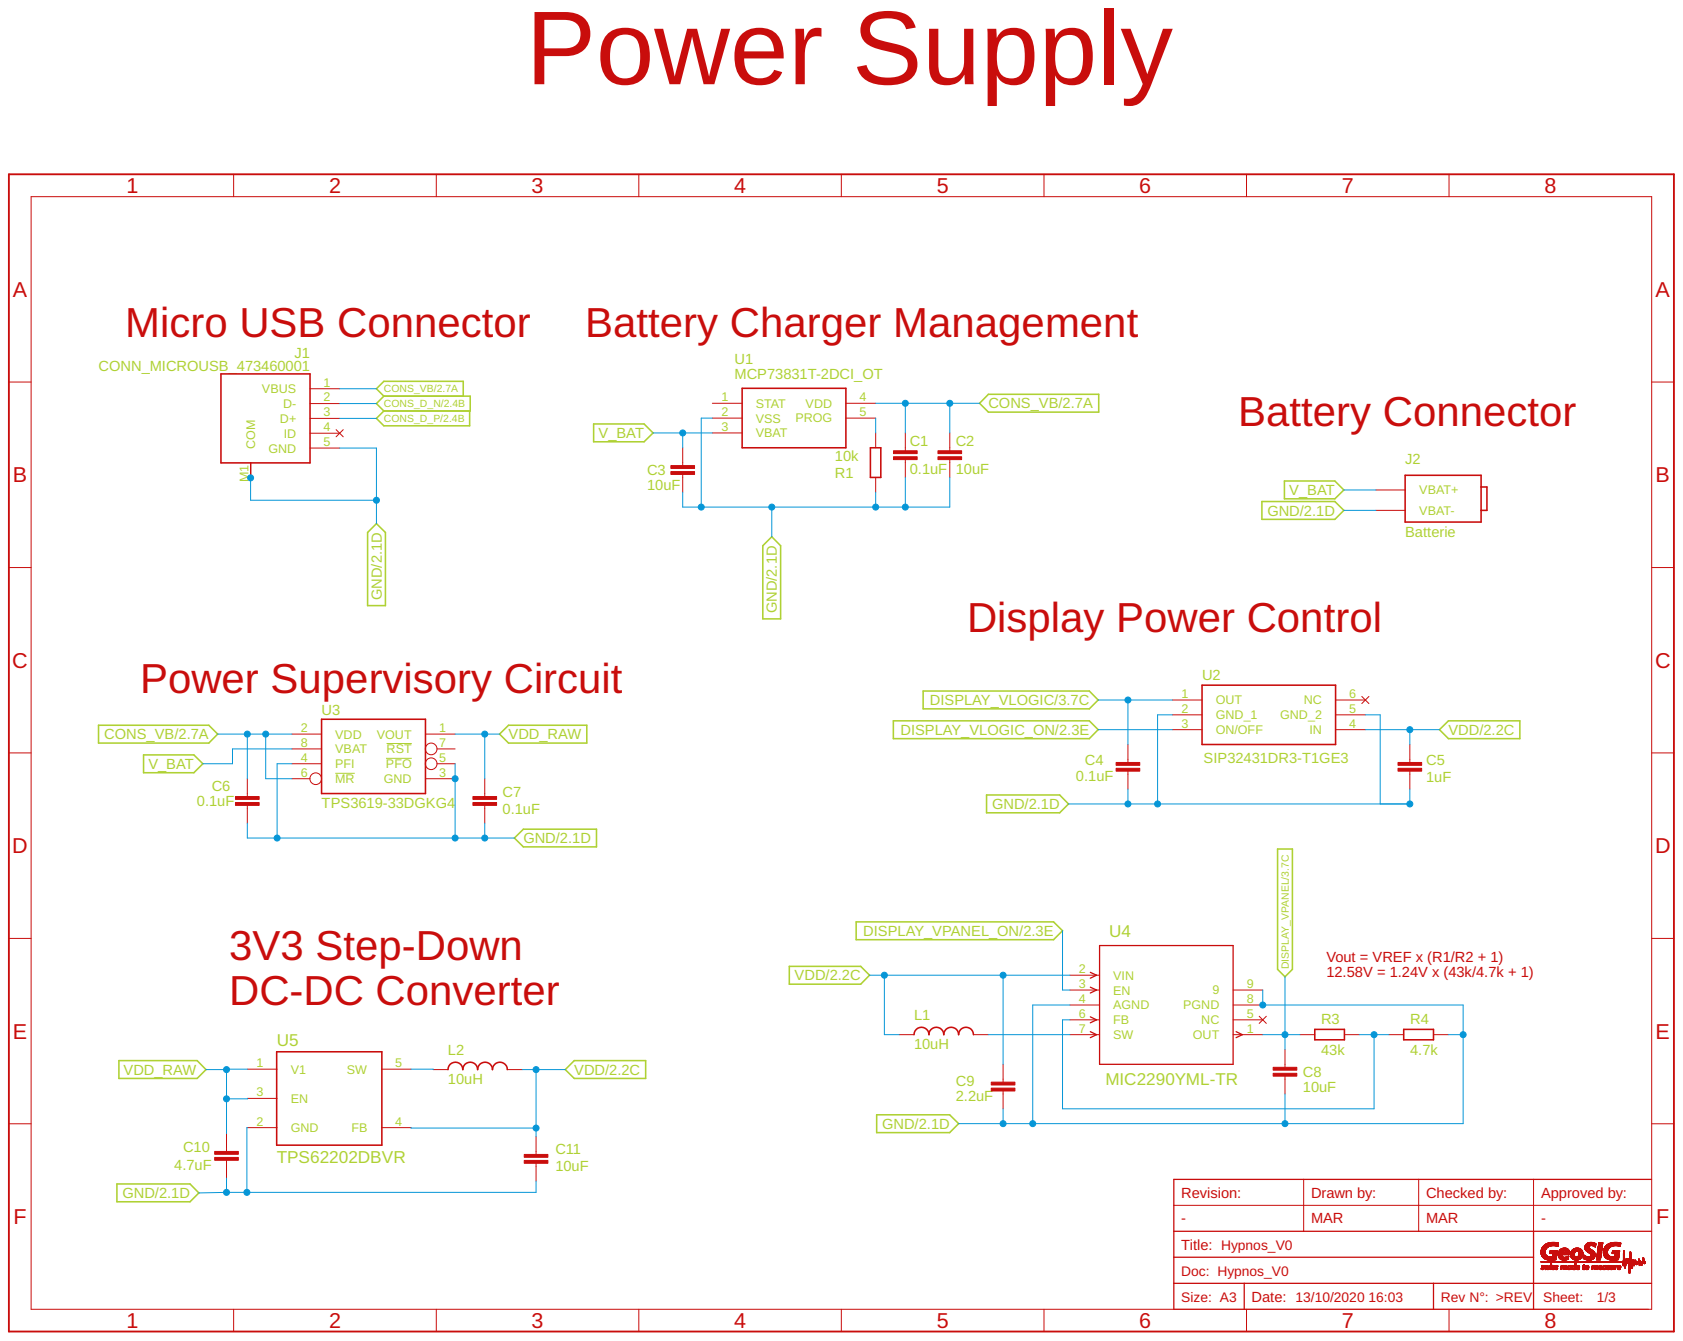
[picture p43: page 1]

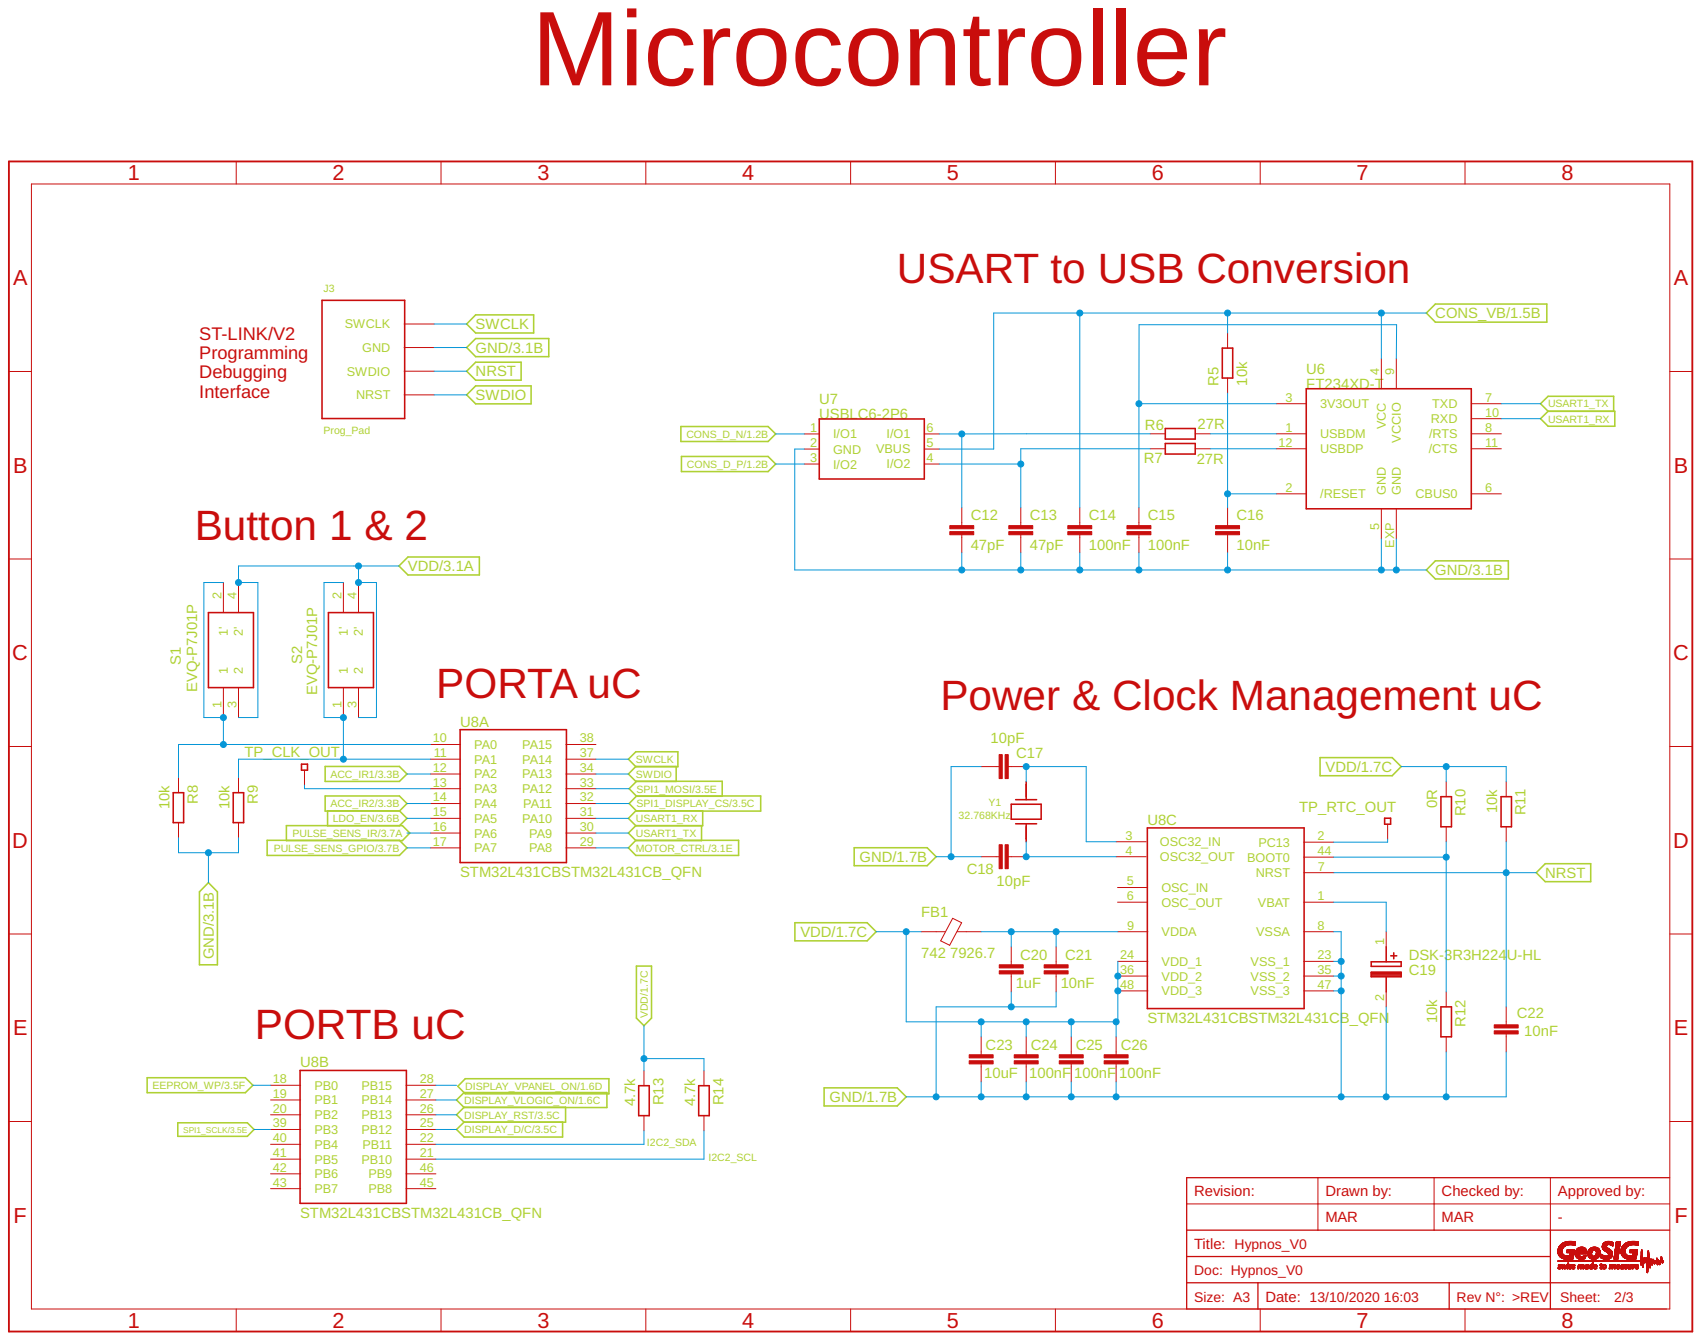
[picture p44: page 2]

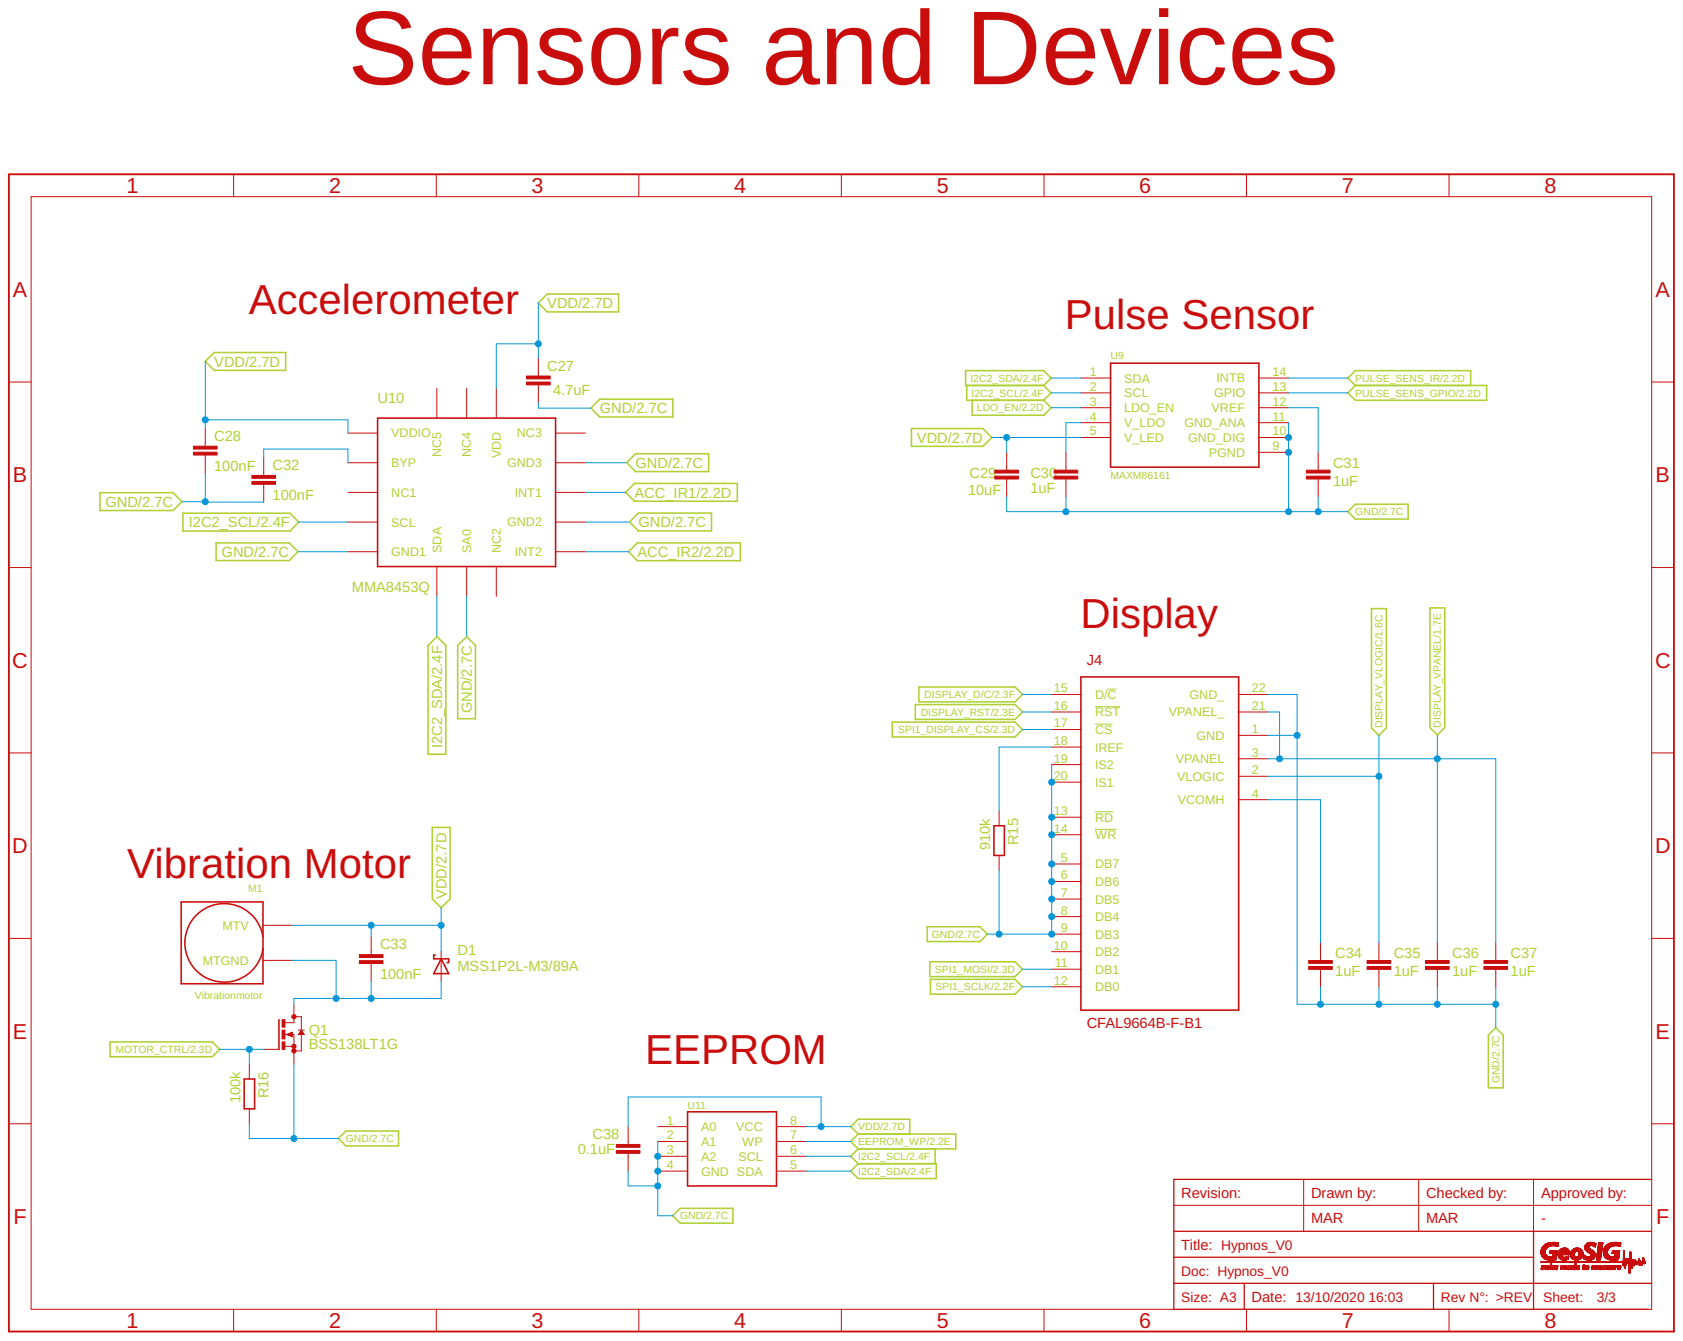
[picture p45: page 3]
