BIG-TTS/Hypnos/Hypnos/Production/Hypnos_V0/Hypnos_V0.brd

## EAGLE design Hypnos/Production/Hypnos_V0/Hypnos_V0.brd (2021-01-15, an earlier design)

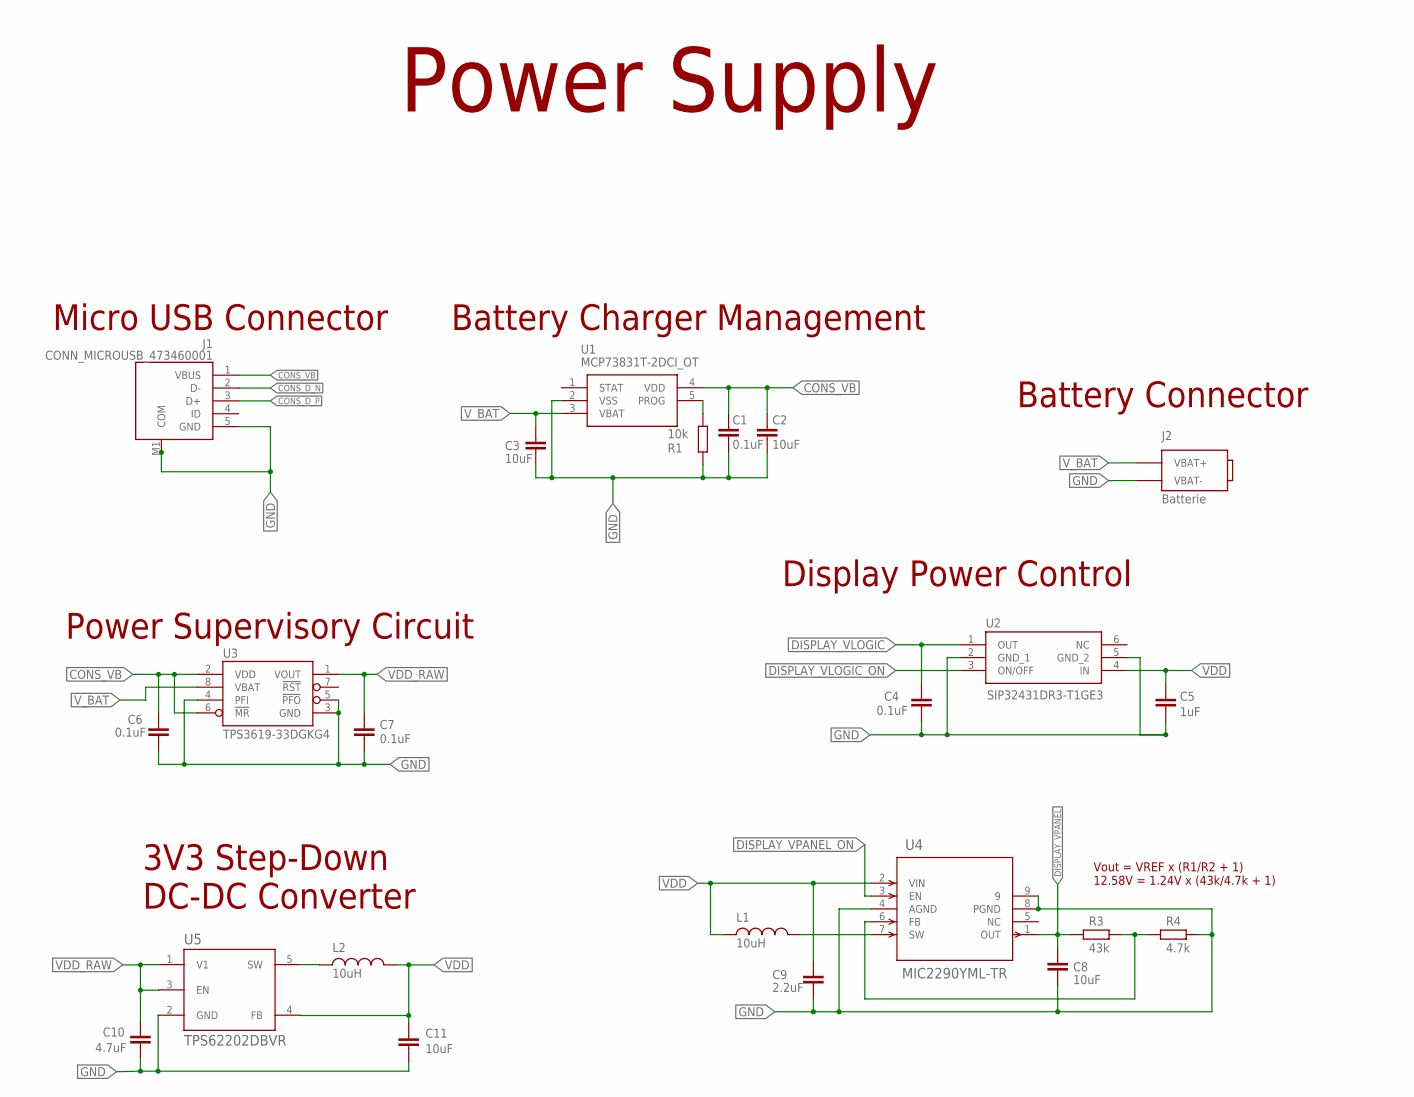
[picture p46: schematic Hypnos_V0.sch, sheet 1]

Parts:
C1, C4, C6, C7: 0.1uF; C0603K
C2, C3, C8, C11: 10uF; C0603K
C5: 1uF; C0603K
C9: 2.2uF; C0603K
C10: 4.7uF; C0603K
J1: CONN_MICROUSB_473460001; CONN_MOLEX_473460001
J2: Batterie; BATTERIE
L1, L2: 10uH; L1210
R1: 10k; R0603
R3: 43k; R0603
R4: 4.7k; R0603
U1: MCP73831T-2DCI_OT; SOT95P270X145-5N
U2: SIP32431DR3-T1GE3; SOT65P210X110-6N
U3: TPS3619-33DGKG4; MSOP8
U4: MIC2290YML-TR; MLF-8_ML_MCH
U5: TPS62202DBVR; SOT95P280X145-5N

Connections:
CONS_D_N: J1.2 (D-); also elsewhere on the board
CONS_D_P: J1.3 (D+); also elsewhere on the board
CONS_VB: C1.1, C2.1, C6.1, J1.1 (VBUS), U1.4 (VDD), U3.2 (VDD), U3.6 (!MR); also elsewhere on the board
DISPLAY_VLOGIC: C4.1, U2.1 (OUT); also elsewhere on the board
DISPLAY_VLOGIC_ON: U2.3 (ON/OFF); also elsewhere on the board
DISPLAY_VPANEL: C8.1, R3.2, U4.1 (OUT); also elsewhere on the board
DISPLAY_VPANEL_ON: U4.3 (EN); also elsewhere on the board
FB: R3.1, R4.2, U4.6 (FB)
GND: C1.2, C2.2, C3.2, C4.2, C5.2, C6.2, C7.2, C8.2, C9.2, C10.2, C11.2, J1.5 (GND), J1.M1 (COM), J1.M2 (COM), J1.M3 (COM), J1.M4 (COM), J1.M5 (COM), J1.M6 (COM), J2.2 (VBAT-), R1.2, R4.1, U1.2 (VSS), U2.2 (GND_1), U2.5 (GND_2), U3.3 (GND), U3.4 (PFI), U3.5 (!PFO), U4.4 (AGND), U4.8 (PGND), U4.9, U5.2 (GND); also elsewhere on the board
unnamed: L2.1, U5.5 (SW)
PROG: R1.1, U1.5 (PROG)
SW: L1.2, U4.7 (SW)
VDD: C5.1, C9.1, C11.1, L1.1, L2.2, U2.4 (IN), U4.2 (VIN), U5.4 (FB); also elsewhere on the board
VDD_RAW: C7.1, C10.1, U3.1 (VOUT), U5.1 (V1), U5.3 (EN)
V_BAT: C3.1, J2.1 (VBAT+), U1.3 (VBAT), U3.8 (VBAT)

Notes on the sheet:
Micro USB Connector
Battery Charger Management
Power Supervisory Circuit
Power Supply
3V3 Step-Down DC-DC Converter
Battery Connector
Display Power Control
Vout = VREF x (R1/R2 + 1) 12.58V = 1.24V x (43k/4.7k + 1)

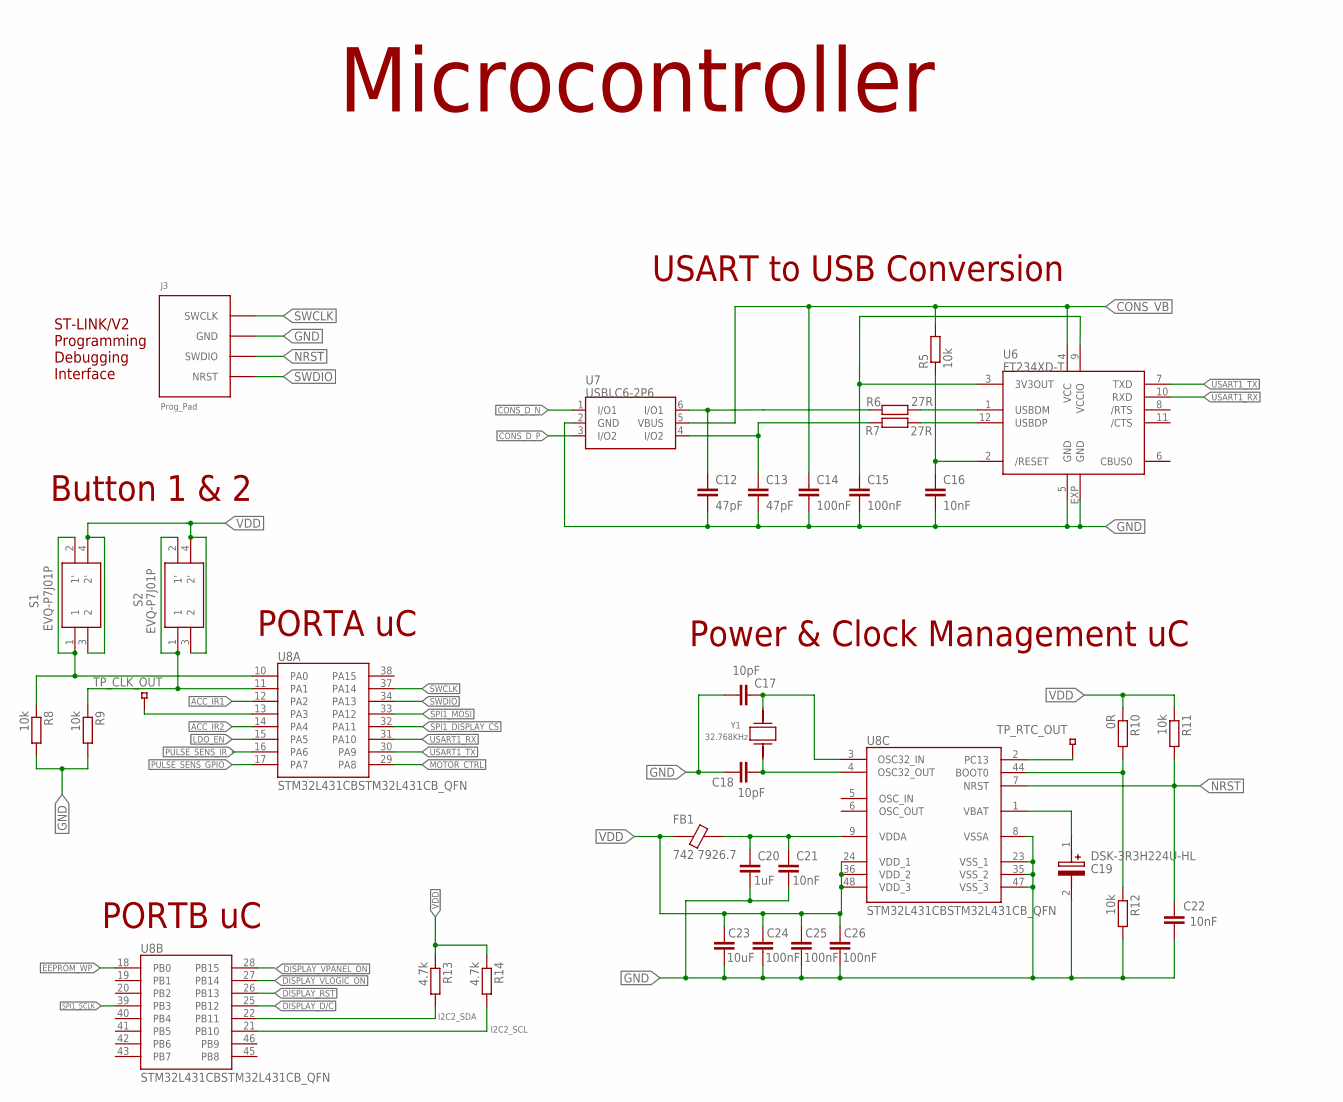
[picture p47: schematic Hypnos_V0.sch, sheet 2]

Parts:
C12, C13: 47pF; C0603K
C14, C15, C24, C25, C26: 100nF; C0603K
C16, C21, C22: 10nF; C0603K
C17, C18: 10pF; C0603K
C19: DSK-3R3H224U-HL; DSK3R3H334THL
C20: 1uF; C0603K
C23: 10uF; C0603K
FB1: 742 7926.7; FB0603
J3: Prog_Pad; PROG_PAD
R5, R8, R9, R11, R12: 10k; R0603
R6, R7: 27R; R0603
R10: 0R; R0603
R13, R14: 4.7k; R0603
S1, S2: EVQ-P7J01P; EVQP7J01P
TP_CLK_OUT: TEST_PIN_SMD; SMD_1
TP_RTC_OUT: TEST_PIN_SMD; SMD_1
U6: FT234XD-T; DFN12-3X3
U7: USBLC6-2P6; SOT666
U8: STM32L431CBSTM32L431CB_QFN; QFN50P700X700X60-49N
Y1: 32.768KHz; CM315

Connections:
/RESET: C16.1, R5.1, U6.2 (/RESET)
ACC_IR1: U8.12 (PA2); also elsewhere on the board
ACC_IR2: U8.14 (PA4); also elsewhere on the board
BUTTON1: R8.1, S1.1, S1.2 (1'), U8.10 (PA0)
BUTTON2: R9.1, S2.1, S2.2 (1'), U8.11 (PA1)
CLK_OUT: TP_CLK_OUT.P$1, U8.13 (PA3)
CONS_D_N: U7.1 (I/O1); also elsewhere on the board
CONS_D_P: U7.3 (I/O2); also elsewhere on the board
CONS_VB: C14.1, R5.2, U6.4 (VCC), U7.5 (VBUS); also elsewhere on the board
DISPLAY_D/C: U8.25 (PB12); also elsewhere on the board
DISPLAY_RST: U8.26 (PB13); also elsewhere on the board
DISPLAY_VLOGIC_ON: U8.27 (PB14); also elsewhere on the board
DISPLAY_VPANEL_ON: U8.28 (PB15); also elsewhere on the board
EEPROM_WP: U8.18 (PB0); also elsewhere on the board
GND: C12.2, C13.2, C14.2, C15.2, C16.2, C17.2, C18.2, C19.2 (-), C20.2, C21.2, C22.2, C23.2, C24.2, C25.2, C26.2, J3.2 (GND), R8.2, R9.2, R12.2, U6.5 (GND), U6.EXP (GND), U7.2 (GND), U8.8 (VSSA), U8.23 (VSS_1), U8.35 (VSS_2), U8.47 (VSS_3); also elsewhere on the board
I2C2_SCL: R14.2, U8.21 (PB10); also elsewhere on the board
I2C2_SDA: R13.2, U8.22 (PB11); also elsewhere on the board
LDO_EN: U8.15 (PA5); also elsewhere on the board
MOTOR_CTRL: U8.29 (PA8); also elsewhere on the board
unnamed: C18.1, U8.4 (OSC32_OUT), Y1.P$2
unnamed: C17.1, U8.3 (OSC32_IN), Y1.P$1
unnamed: C19.1 (+), U8.1 (VBAT)
unnamed: R10.2, R12.1, U8.44 (BOOT0)
unnamed: C13.1, R7.2, U7.4 (I/O2)
unnamed: C12.1, R6.2, U7.6 (I/O1)
NRST: C22.1, J3.3 (SWDIO), R11.2, U8.7 (NRST)
PULSE_SENS_GPIO: U8.17 (PA7); also elsewhere on the board
PULSE_SENS_IR: U8.16 (PA6); also elsewhere on the board
RTC_OUT: TP_RTC_OUT.P$1, U8.2 (PC13)
SPI1_DISPLAY_CS: U8.32 (PA11); also elsewhere on the board
SPI1_MOSI: U8.33 (PA12); also elsewhere on the board
SPI1_SCLK: U8.39 (PB3); also elsewhere on the board
SWCLK: J3.1 (SWCLK), U8.37 (PA14)
SWDIO: J3.4 (NRST), U8.34 (PA13)
USART1_RX: U6.10 (RXD), U8.31 (PA10)
USART1_TX: U6.7 (TXD), U8.30 (PA9)
USBDM: R6.1, U6.1 (USBDM)
USBDP: R7.1, U6.12 (USBDP)
VCCIO: C15.1, U6.3 (3V3OUT), U6.9 (VCCIO)
VDD: C23.1, C24.1, C25.1, C26.1, FB1.1, R10.1, R11.1, R13.1, R14.1, S1.3 (2), S1.4 (2'), S2.3 (2), S2.4 (2'), U8.24 (VDD_1), U8.36 (VDD_2), U8.48 (VDD_3); also elsewhere on the board
VDDA: C20.1, C21.1, FB1.2, U8.9 (VDDA)

Notes on the sheet:
ST-LINK/V2 Programming Debugging Interface
USART to USB Conversion
Power & Clock Management uC
PORTA uC
PORTB uC
Microcontroller
Button 1 & 2

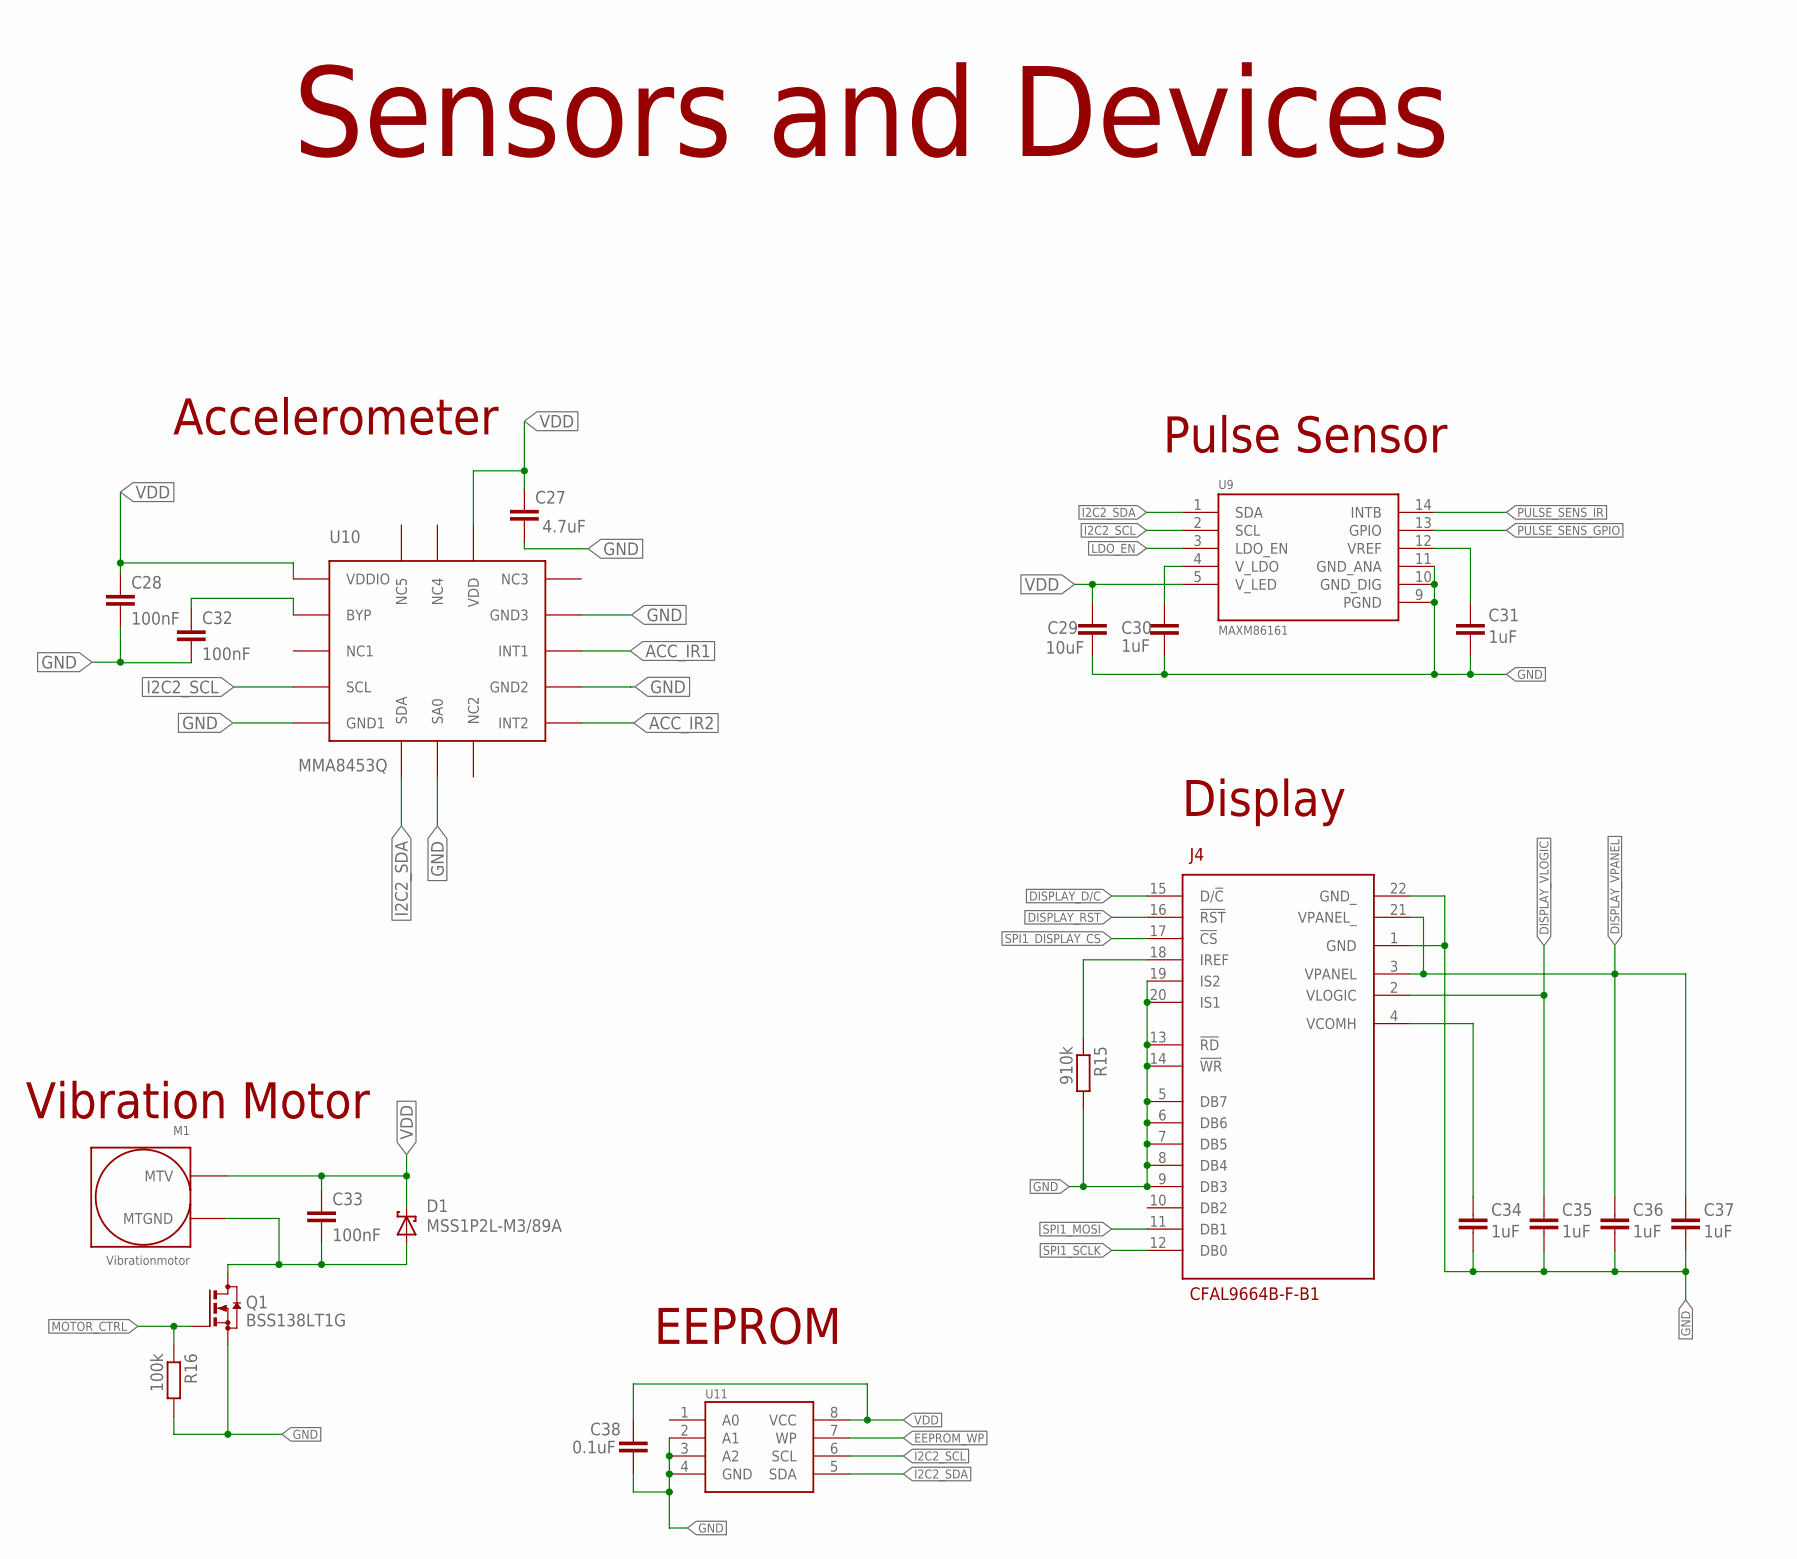
[picture p48: schematic Hypnos_V0.sch, sheet 3]

Parts:
C27: 4.7uF; C0603K
C28, C32, C33: 100nF; C0603K
C29: 10uF; C0603K
C30, C31, C34, C35, C36, C37: 1uF; C0603K
C38: 0.1uF; C0603K
D1: MSS1P2L-M3/89A; MICROSMP
J4: CFAL9664B-F-B1
M1: Vibrationmotor; VIBRATIONMOTOR
Q1: BSS138LT1G; SOT23
R15: 910k; R0603
R16: 100k; R0603
U9: MAXM86161
U10: MMA8453Q; QFN-COL
U11: BR24T1MFJ-3AME2; SOIC127P600X165-8N

Connections:
ACC_IR1: U10.P$11 (INT1); also elsewhere on the board
ACC_IR2: U10.P$9 (INT2); also elsewhere on the board
BYP: C32.1, U10.P$2 (BYP)
DISPLAY_D/C: J4.15 (D/!C); also elsewhere on the board
DISPLAY_RST: J4.16 (!RST); also elsewhere on the board
DISPLAY_VLOGIC: C35.1, J4.2 (VLOGIC); also elsewhere on the board
DISPLAY_VPANEL: C36.1, C37.1, J4.3 (VPANEL), J4.21 (VPANEL_); also elsewhere on the board
EEPROM_WP: U11.7 (WP); also elsewhere on the board
GND: C27.2, C28.2, C29.2, C30.2, C31.2, C32.2, C34.2, C35.2, C36.2, C37.2, C38.2, J4.1 (GND), J4.5 (DB7), J4.6 (DB6), J4.7 (DB5), J4.8 (DB4), J4.9 (DB3), J4.13 (!RD!), J4.14 (!WR!), J4.19 (IS2), J4.20 (IS1), J4.22 (GND_), Q1.2 (S), R15.2, R16.2, U9.9 (PGND), U9.10 (GND_DIG), U9.11 (GND_ANA), U10.P$5 (GND1), U10.P$7 (SA0), U10.P$10 (GND2), U10.P$12 (GND3), U11.2 (A1), U11.3 (A2), U11.4 (GND); also elsewhere on the board
I2C2_SCL: U9.2 (SCL), U10.P$4 (SCL), U11.6 (SCL); also elsewhere on the board
I2C2_SDA: U9.1 (SDA), U10.P$6 (SDA), U11.5 (SDA); also elsewhere on the board
IREF: J4.18 (IREF), R15.1
LDO_EN: U9.3 (LDO_EN); also elsewhere on the board
MOTOR_CTRL: Q1.1 (G), R16.1; also elsewhere on the board
MTGND: C33.2, D1.A, M1.1 (MTGND), Q1.3 (D)
PULSE_SENS_GPIO: U9.13 (GPIO); also elsewhere on the board
PULSE_SENS_IR: U9.14 (INTB); also elsewhere on the board
SPI1_DISPLAY_CS: J4.17 (!CS); also elsewhere on the board
SPI1_MOSI: J4.11 (DB1); also elsewhere on the board
SPI1_SCLK: J4.12 (DB0); also elsewhere on the board
VCOMH: C34.1, J4.4 (VCOMH)
VDD: C27.1, C28.1, C29.1, C33.1, C38.1, D1.C, M1.2 (MTV), U9.5 (V_LED), U10.P$1 (VDDIO), U10.P$14 (VDD), U11.8 (VCC); also elsewhere on the board
V_LDO: C30.1, U9.4 (V_LDO)
V_REF: C31.1, U9.12 (VREF)

Notes on the sheet:
Accelerometer
EEPROM
Pulse Sensor
Sensors and Devices
Vibration Motor
Display

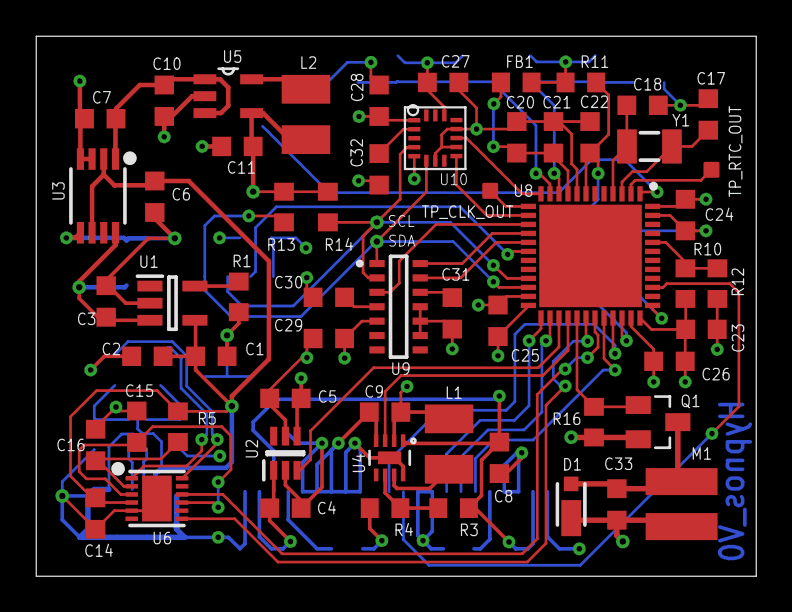
[picture p49: board Hypnos_V0.brd from above]

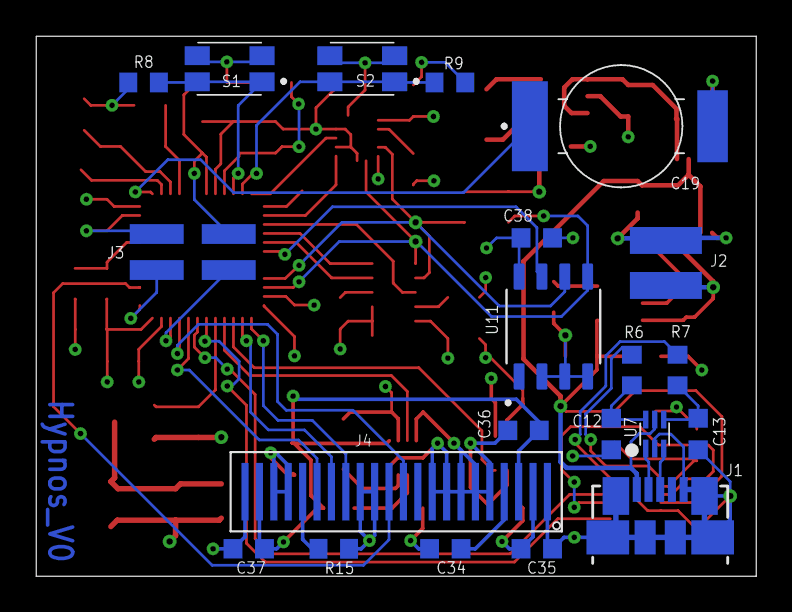
[picture p50: board Hypnos_V0.brd from below]

Board: 4 copper layers, 40.0 x 30.0 mm, 80 parts (21 on the bottom side), 55 nets.

Other parts of the board:
DRILEGEND: DRILEGEND
