BIG-TTS/Hypnos/Hypnos_Cube/New Folder (2).ioc

Mcu.UserName=STM32L431CBTx
PA0.Signal=S_TIM2_CH1
PA1.Signal=S_TIM2_CH2
PA10.Signal=USART1_RX
PA11.Signal=GPIO_Output
PA12.Signal=SPI1_MOSI
PA2.Signal=GPXTI2
PA3.Signal=S_TIM15_CH2
PA4.Signal=GPXTI4
PA5.Signal=GPXTI5
PA6.Signal=GPIO_Output
PA7.Signal=GPIO_Output
PA8.Signal=GPIO_Output
PA9.Signal=USART1_TX
PB0.Signal=GPIO_Output
PB1.Signal=GPIO_Output
PB10.Signal=I2C2_SCL
PB11.Signal=I2C2_SDA
PB12.Signal=GPIO_Output
PB13.Signal=GPIO_Output
PB14.Signal=GPIO_Output
PB15.Signal=GPIO_Output
