BIG-TTS/Hypnos/Hypnos_Code/BIO_Init.h

/*-----------------------------------
Author: Marco Rouge / Andrin Kälin
Arbeit: Hypnos
Thema: Header for Biosensor configuration
Datum: 17.01.2021
-------------------------------------*/

#ifndef __BIO_Init__
#define __BIO_Init__

//--- FUNCTION HEADERS -------------------$
unsigned int BIO_read(void);
void BIO_init(void);
//--- FUNCTION HEADERS -------------------$

//--- DEFINES ----------------------------$
#define BIO_slv_add	0x62
//--- DEFINES ----------------------------$

#endif
