BIG-TTS/Hypnos/Hypnos_Code/COMMON.c

/*-----------------------------------
Author: Marco Rouge / Andrin Kälin
Arbeit: Hypnos
Thema: COMMON File for Project: includes, defines and macros
Datum: 17.01.2021
-------------------------------------*/
#ifndef __COMMON
#define __COMMON
//--- INCLUDES -----------------------$
#include <stm32l431xx.h>
#include "system_init.h"
#include "GPIO.h"
#include "USART.h"
#include "BIO_Init.h"
//--- INCLUDES -----------------------$

//--- DEFINES ------------------------$

//--- DEFINES ------------------------$

//--- MACROS -------------------------$

//--- MACROS -------------------------$

#endif
