BIG-TTS/Hypnos/Hypnos_Code/system_init.h

/*-----------------------------------
Author: Marco Rouge / Andrin Kälin
Arbeit: Hypnos
Thema: Header fiel for system startup
Datum: 17.01.2021
-------------------------------------*/
#ifndef __system_init__
#define __system_init__

//--- FUNCTION HEADERS ----------------------------$
void system_clock_init(void);	//Initialization of RCC and clocks
//--- FUNCTION HEADERS ----------------------------$

#endif
