BIG-TTS/Hypnos/(notices)

Notices in the files:
parts and their libraries:
MIC2290YML-TR: COPYRIGHT: Copyright (C) 2018 Accelerated Designs. All rights reserved
